nppesnteam/371-24_EKB_academ_PTVM30_-8/DeskRender.jpg

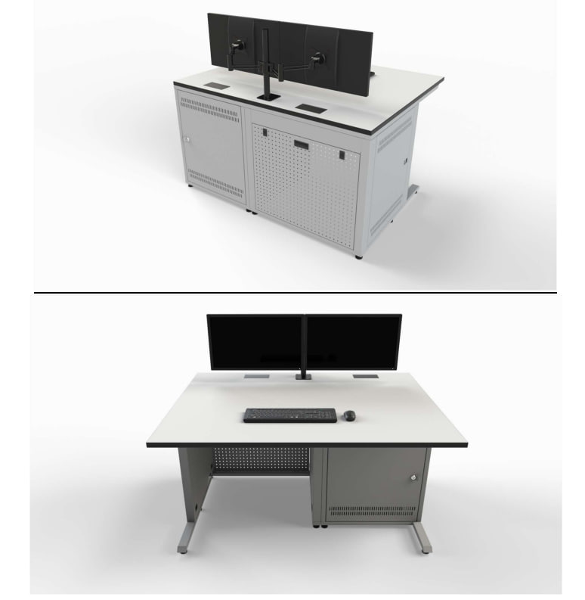
DeskRender.jpg
