nppesnteam/371-24_EKB_academ_PTVM30_-8/DeskSize.jpg

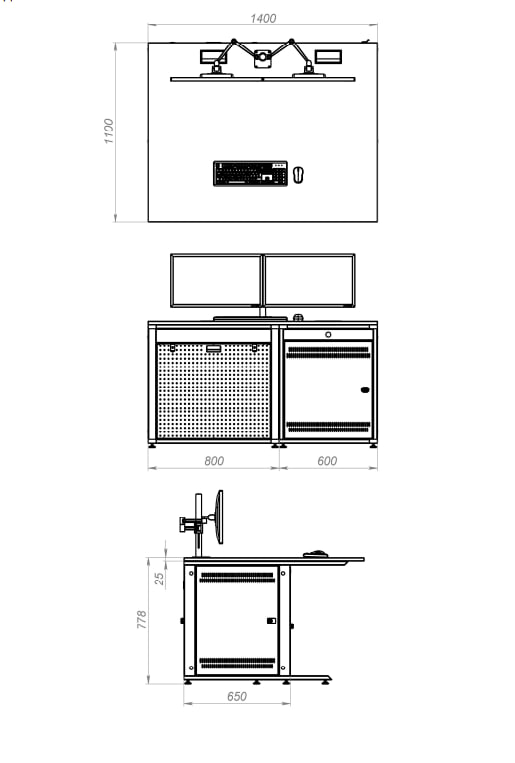
DeskSize.jpg
