nppesnteam/371-24_EKB_academ_PTVM30_-8/Счет №3499 от 23.05.24-1.JPG

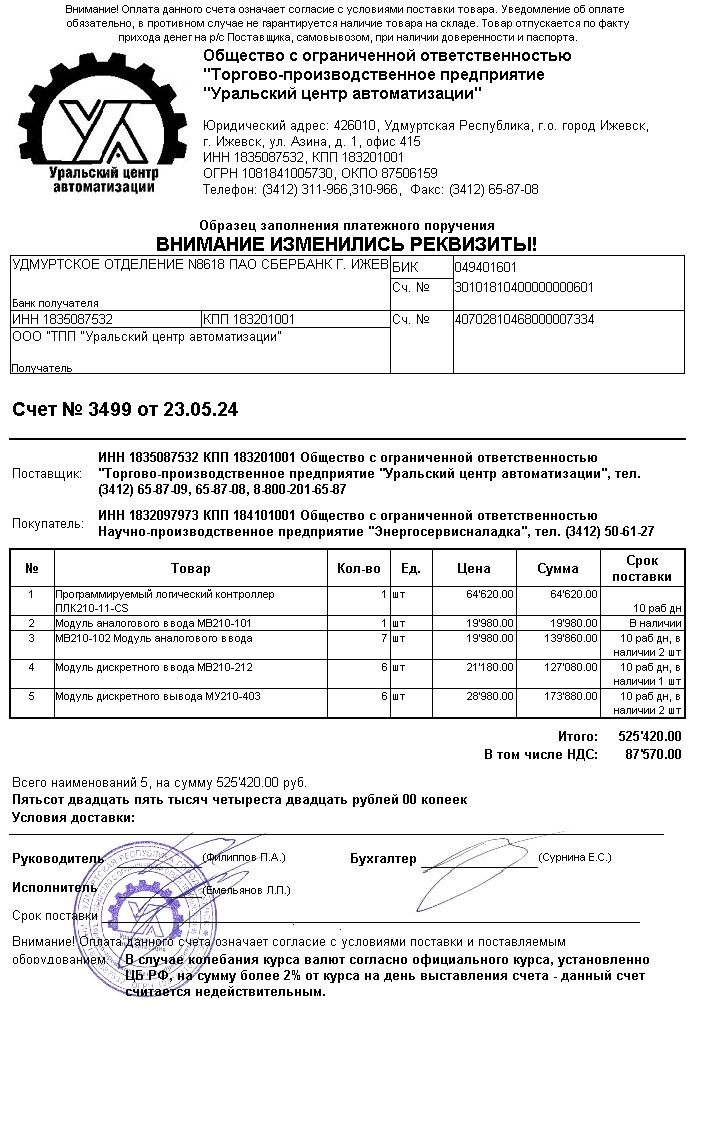
Счет №3499 от 23.05.24-1.JPG
