nppesnteam/371-24_EKB_academ_PTVM30_-8/model371.xlsx

Sheet: 240521кор
№ п/п | шифр | назначение | наименование | производитель | предел от | предел до | ед.изм | Ду | эн.потр | масса | цена без НДС | дата цены | схема эл. | схема монт. | параметры схем
115 | х8СН001 | Датчик контроля загазованности по метану | ДАК-СН4-027 | Аналитприбор, Смоленск
116 | х8СН002 | Датчик контроля загазованности по метану | ДАК-СН4-027 | Аналитприбор, Смоленск
117 | х8СН003 | Датчик контроля загазованности по метану | ДАК-СН4-027 | Аналитприбор, Смоленск
118 | х8СО001 | Датчик контроля загазованности по угарному газу | ДАХ-М-05-СО-200 | Аналитприбор, Смоленск
119 | х8СО002 | Датчик контроля загазованности по угарному газу | ДАХ-М-05-СО-200 | Аналитприбор, Смоленск
31 | g8Ps005 | Давление газа после заслонки котла (Рмин) | Датчик-реле DG30В-3 0,25…3 кПа G.Kromschroeder. | Волгатерм, Нижний Новгород | 0.25 | 3 | кПа
32 | g8Ps006 | Давление газа после заслонки котла (Рмакс) | Датчик-реле DG500В-3 10…50 кПа G.Kromschroeder. | Волгатерм, Нижний Новгород | 10 | 50 | кПа
48 | f8Ps001 | Разрежение в топке котла (мин разреж) | Датчик-реле DL1,5A-3Z -50…150 Па G.Kromschroeder. | Волгатерм, Нижний Новгород | -50 | 150 | Па
71 | a8Ps111 | Давление воздуха перед горелкой 1 (Рмин) | Датчик-реле DG10А-31 0,1…1 кПа G.Kromschroeder. | Волгатерм, Нижний Новгород | 0.1 | 1 | кПа
72 | a8Ps121 | Давление воздуха перед горелкой 2 (Рмин) | Датчик-реле DG10А-31 0,1…1 кПа G.Kromschroeder. | Волгатерм, Нижний Новгород | 0.1 | 1 | кПа
73 | a8Ps131 | Давление воздуха перед горелкой 3 (Рмин) | Датчик-реле DG10А-31 0,1…1 кПа G.Kromschroeder. | Волгатерм, Нижний Новгород | 0.1 | 1 | кПа
74 | a8Ps241 | Давление воздуха перед горелкой 4 (Рмин) | Датчик-реле DG10А-31 0,1…1 кПа G.Kromschroeder. | Волгатерм, Нижний Новгород | 0.1 | 1 | кПа
75 | a8Ps251 | Давление воздуха перед горелкой 5 (Рмин) | Датчик-реле DG10А-31 0,1…1 кПа G.Kromschroeder. | Волгатерм, Нижний Новгород | 0.1 | 1 | кПа
76 | a8Ps261 | Давление воздуха перед горелкой 6 (Рмин) | Датчик-реле DG10А-31 0,1…1 кПа G.Kromschroeder. | Волгатерм, Нижний Новгород | 0.1 | 1 | кПа
27 | g8Pg002 | Давление газа до общей заслонки газа | Манометр показывающий МП4-У У2; 0-60 кПа кл.1,0 160мм | Манотомь, Томск | 0 | 60 | кПа
30 | g8Pg004 | Давление газа после общей заслонки | Манометр показывающий МП4-У У2; 0-60 кПа кл.1,0 160мм | Манотомь, Томск | 0 | 60 | кПа
33 | g8Pg007 | Давление газа между задвижками | Манометр показывающий МП4-У У2; 0-60 кПа кл.1,0 160мм | Манотомь, Томск | 0 | 60 | кПа
34 | g8Pg008 | Давление газа перед главным отсекающим клапаном | Манометр показывающий МП4-У У2; 0-60 кПа кл.1,0 160мм | Манотомь, Томск | 0 | 60 | кПа
112 | w8Pg021 | Давление теплоносителя до котла | Манометр показывающий МП4-У У2; 0-1,6 МПа кл.1,0 160мм | Манотомь, Томск | 0 | 1.6 | МПа
83 | b8X101 | Датчик пламени растопочной горелки 1 группы горелок 1 | ФДСА-03М-01, узел монтажный и фланец к нему | НПП ПромАВ, Казань
84 | b8X111 | Защитно-сигнализирующее утройство горелки 1 | ЗСУ-ПИ-60-700-01 | НПП ПромАВ, Казань
85 | b8X112 | Датчик пламени ЗСУ горелки 1 | ЛУЧ-КЭ-Щв комплекте ЗСУ | НПП ПромАВ, Казань
86 | b8X113 | Источник высокого напряжения ЗСУ горелки 1 | ИВН-ТРМв комплекте ЗСУ | НПП ПромАВ, Казань
87 | b8X121 | Защитно-сигнализирующее утройство горелки 2 | ЗСУ-ПИ-60-700-01 | НПП ПромАВ, Казань
88 | b8X122 | Датчик пламени ЗСУ горелки 2 | ЛУЧ-КЭ-Щ в комплекте ЗСУ | НПП ПромАВ, Казань
89 | b8X123 | Источник высокого напряжения ЗСУ горелки 2 | ИВН-ТРМ в комплекте ЗСУ | НПП ПромАВ, Казань
90 | b8X131 | Защитно-сигнализирующее утройство горелки 3 | ЗСУ-ПИ-60-700-01 | НПП ПромАВ, Казань
91 | b8X132 | Датчик пламени ЗСУ горелки 3 | ЛУЧ-КЭ-Щ в комплекте ЗСУ | НПП ПромАВ, Казань
92 | b8X133 | Источник высокого напряжения ЗСУ горелки 3 | ИВН-ТРМ в комплекте ЗСУ | НПП ПромАВ, Казань
93 | b8X201 | Датчик пламени растопочной горелки 6 группы горелок 2 | ФДСА-03М-01, узел монтажный и фланец к нему | НПП ПромАВ, Казань
94 | b8X241 | Защитно-сигнализирующее утройство горелки 4 | ЗСУ-ПИ-60-700-01 | НПП ПромАВ, Казань
95 | b8X242 | Датчик пламени ЗСУ горелки 4 | ЛУЧ-КЭ-Щ в комплекте ЗСУ | НПП ПромАВ, Казань
96 | b8X243 | Источник высокого напряжения ЗСУ горелки 4 | ИВН-ТРМ в комплекте ЗСУ | НПП ПромАВ, Казань
97 | b8X251 | Защитно-сигнализирующее утройство горелки 5 | ЗСУ-ПИ-60-700-01 | НПП ПромАВ, Казань
98 | b8X252 | Датчик пламени ЗСУ горелки 5 | ЛУЧ-КЭ-Щ в комплекте ЗСУ | НПП ПромАВ, Казань
99 | b8X253 | Источник высокого напряжения ЗСУ горелки 5 | ИВН-ТРМ в комплекте ЗСУ | НПП ПромАВ, Казань
100 | b8X261 | Защитно-сигнализирующее утройство горелки 6 | ЗСУ-ПИ-60-700-01 | НПП ПромАВ, Казань
101 | b8X262 | Датчик пламени ЗСУ горелки 6 | ЛУЧ-КЭ-Щ в комплекте ЗСУ | НПП ПромАВ, Казань
102 | b8X263 | Источник высокого напряжения ЗСУ горелки 6 | ИВН-ТРМ в комплекте ЗСУ | НПП ПромАВ, Казань
37 | g8Pg102 | Давление газа перед группой горелок 1 | Напоромер мембранный НМП-100- М1Р-40кПа. ТУ-25-7305.016-90 | Саранский приборострительный завод | 0 | 40 | кПа
38 | g8Pg202 | Давление газа перед группой горелок 2 | Напоромер мембранный НМП-100- М1Р-40кПа. ТУ-25-7305.016-90 | Саранский приборострительный завод | 0 | 40 | кПа
39 | g8Pt111 | Давление газа перед горелкой 1 | Напоромер мембранный НМП-52-М2- 40кПа-1,5- У3 | Саранский приборострительный завод | 0 | 40 | кПа
40 | g8Pt121 | Давление газа перед горелкой 2 | Напоромер мембранный НМП-52-М2- 40кПа-1,5- У3 | Саранский приборострительный завод | 0 | 40 | кПа
41 | g8Pt131 | Давление газа перед горелкой 3 | Напоромер мембранный НМП-52-М2- 40кПа-1,5- У3 | Саранский приборострительный завод | 0 | 40 | кПа
42 | g8Pt241 | Давление газа перед горелкой 4 | Напоромер мембранный НМП-52-М2- 40кПа-1,5- У3 | Саранский приборострительный завод | 0 | 40 | кПа
43 | g8Pt251 | Давление газа перед горелкой 5 | Напоромер мембранный НМП-52-М2- 40кПа-1,5- У3 | Саранский приборострительный завод | 0 | 40 | кПа
44 | g8Pt261 | Давление газа перед горелкой 6 | Напоромер мембранный НМП-52-М2- 40кПа-1,5- У3 | Саранский приборострительный завод | 0 | 40 | кПа
47 | f8Pg001 | Разрежение в топке котла | Тягонапоромер мембранный ТНМП-100-М1- ±0,125кПа-1,5- У3 | Саранский приборострительный завод | -0.125 | 0.125 | кПа
50 | f8Pg002 | Разрежение перед дымососом | Тягонапоромер мембранный ТмМП-52-М2- 0,6кПа..0-1,5- У3 | Саранский приборострительный завод | -0.6 | 0 | кПа
56 | a8Pg101 | Давления воздуха после вентилятора группы горелок 1 | Напоромер мембранный НМП-52-М2- 2,5кПа-1,5- У3 | Саранский приборострительный завод | 0 | 2.5 | кПа
60 | a8Pg201 | Давления воздуха после вентилятора группы горелок 2 | Напоромер мембранный НМП-52-М2- 2,5кПа-1,5- У3 | Саранский приборострительный завод | 0 | 2.5 | кПа
63 | a8Pg002 | Давления воздуха в общем коллекторе | Напоромер мембранный НМП-52-М2- 2,5кПа-1,5- У3 | Саранский приборострительный завод | 0 | 2.5 | кПа
65 | a8Pg111 | Давление воздуха перед горелкой 1 | Напоромер мембранный НМП-52-М2- 2,5кПа-1,5- У3 | Саранский приборострительный завод | 0 | 2.5 | кПа
66 | a8Pg121 | Давление воздуха перед горелкой 2 | Напоромер мембранный НМП-52-М2- 2,5кПа-1,5- У3 | Саранский приборострительный завод | 0 | 2.5 | кПа
67 | a8Pg131 | Давление воздуха перед горелкой 3 | Напоромер мембранный НМП-52-М2- 2,5кПа-1,5- У3 | Саранский приборострительный завод | 0 | 2.5 | кПа
68 | a8Pg241 | Давление воздуха перед горелкой 4 | Напоромер мембранный НМП-52-М2- 2,5кПа-1,5- У3 | Саранский приборострительный завод | 0 | 2.5 | кПа
69 | a8Pg251 | Давление воздуха перед горелкой 5 | Напоромер мембранный НМП-52-М2- 2,5кПа-1,5- У3 | Саранский приборострительный завод | 0 | 2.5 | кПа
70 | a8Pg261 | Давление воздуха перед горелкой 6 | Напоромер мембранный НМП-52-М2- 2,5кПа-1,5- У3 | Саранский приборострительный завод | 0 | 2.5 | кПа
46 | f8sM002 | Шибер дымососа | МЭО-630/63-0,25У-08К | СКБ СПА, Чебоксары
55 | a8sM101 | Шибер воздуха вентилятора группы горелок 1 | МЭО-250/63-0,25У-08К | СКБ СПА, Чебоксары
59 | a8sM201 | Шибер воздуха вентилятора группы горелок 2 | МЭО-250/63-0,25У-08К | СКБ СПА, Чебоксары
77 | a8sM111 | Шибер воздуха горелки 1 | МЭО-100/25-0,25У-08 | СКБ СПА, Чебоксары
78 | a8sM121 | Шибер воздуха горелки 2 | МЭО-100/25-0,25У-08 | СКБ СПА, Чебоксары
79 | a8sM131 | Шибер воздуха горелки 3 | МЭО-100/25-0,25У-08 | СКБ СПА, Чебоксары
80 | a8sM241 | Шибер воздуха горелки 4 | МЭО-100/25-0,25У-08 | СКБ СПА, Чебоксары
81 | a8sM251 | Шибер воздуха горелки 5 | МЭО-100/25-0,25У-08 | СКБ СПА, Чебоксары
82 | a8sM261 | Шибер воздуха горелки 6 | МЭО-100/25-0,25У-08 | СКБ СПА, Чебоксары
106 | w8Tg012 | Температура теплоносителя после котла | Термометр биметаллический ТБ-2Р(0…200)-1,5-250-10-М20 ТУ 311-00225621.160-96 | Теплоконтроль, Казань | 0 | 200 | град.С
114 | w8Tg022 | Температура теплоносителя до котла | Термометр биметаллический ТБ-2Р(0…200)-1,5-250-10-М20 ТУ 311-00225621.160-96 | Теплоконтроль, Казань | 0 | 200 | град.С
2 | g8V002 | Главный ПЗК НЗ котла | ВН8Н-6Пст | Термобрест |  | 600 | кПа | 200
3 | g8sM003 | Заслонка общекотловая | ЗР6-6ВПРст | Термобрест |  | 600 | кПа | 150
4 | g8V004 | Клапан НЗ продувки между задвижками | ВН2Н-6Пст.фл | Термобрест |  | 600 | кПа | 50
5 | g8V005 | Клапан НЗ продувки газопровода перед ГОК | ВН2Н-6Пст.фл | Термобрест |  | 600 | кПа | 50
6 | g8V006 | Клапан НЗ продувки газопровода из тупика | ВН2Н-6Пст.фл | Термобрест |  | 600 | кПа | 50
7 | g8V101 | ПЗК1 НЗ группы горелок 1 | ВН6Н-6Пст | Термобрест |  | 600 | кПа | 150
8 | g8V201 | ПЗК1 НЗ группы горелок 2 | ВН6Н-6Пст | Термобрест |  | 600 | кПа | 150
9 | g8V102 | Клапан НЗ опрессовки группы горелок 1 | ВН¾Н-6Пст | Термобрест |  | 600 | кПа | 20
10 | g8V202 | Клапан НЗ опрессовки группы горелок 2 | ВН¾Н-6Пст | Термобрест |  | 600 | кПа | 20
11 | g8V103 | Клапан НО безопасности группы горелок 1 | ВФ1Н-6Пст | Термобрест |  | 600 | кПа | 25
12 | g8V203 | Клапан НО безопасности группы горелок 2 | ВФ1Н-6Пст | Термобрест |  | 600 | кПа | 25
13 | g8VsM111 | ПЗК2 НЗ горелки 1 со встроенной заслонкой после него | ВН3М-3КПст(SP0) | Термобрест |  | 300 | кПа | 80
14 | g8VsM121 | ПЗК2 НЗ горелки 2 со встроенной заслонкой после него | ВН3М-3КПст(SP0) | Термобрест |  | 300 | кПа | 80
15 | g8VsM131 | ПЗК2 НЗ горелки 3 со встроенной заслонкой после него | ВН3М-3КПст(SP0) | Термобрест |  | 300 | кПа | 80
16 | g8VsM241 | ПЗК2 НЗ горелки 4 со встроенной заслонкой после него | ВН3М-3КПст(SP0) | Термобрест |  | 300 | кПа | 80
17 | g8VsM251 | ПЗК2 НЗ горелки 5 со встроенной заслонкой после него | ВН3М-3КПст(SP0) | Термобрест |  | 300 | кПа | 80
18 | g8VsM261 | ПЗК2 НЗ горелки 6 со встроенной заслонкой после него | ВН3М-3КПст(SP0) | Термобрест |  | 300 | кПа | 80
19 | g8V112 | Клапан НЗ запальника горелки 1 | ВН¾Н-6Пст | Термобрест |  | 600 | кПа | 20
20 | g8V122 | Клапан НЗ запальника горелки 2 | ВН¾Н-6Пст | Термобрест |  | 600 | кПа | 20
21 | g8V132 | Клапан НЗ запальника горелки 3 | ВН¾Н-6Пст | Термобрест |  | 600 | кПа | 20
22 | g8V242 | Клапан НЗ запальника горелки 4 | ВН¾Н-6Пст | Термобрест |  | 600 | кПа | 20
23 | g8V252 | Клапан НЗ запальника горелки 5 | ВН¾Н-6Пст | Термобрест |  | 600 | кПа | 20
24 | g8V262 | Клапан НЗ запальника горелки 6 | ВН¾Н-6Пст | Термобрест |  | 600 | кПа | 20
25 | g8dPt001 | Перепад давление газа на диафрагме (расход) | Преобразователь давления измерительный АИР-20/М2/-/Н//ДД/410/-/-/11V/А3И1/t4070/A01/0...6,3кПа/10МПа/42/ШР-14/К1+/IP65/КР3/-/Y(С30)/KKS/ГП/ТУ, Блок клапанный ЭЛЕМЕР-БК/С/3/0/-/02/03/Р5/t4070 У3/ДР/М20УМ/- в комплекте с диафрагмой ДКС и устройством подготовки потока УПП | Элемер, Зеленоград МО | 0 | 6.3 | кПа
26 | g8Pt002 | Давление газа перед общекотловой заслонкой | Преобразователь давления измерительный АИР-20/М2/-/Н//ДИ/130/-/М20/11N/А3И1/t4070/А00/0...60кПа/42/ШР-14/К1+/IP65/КР2/Т7ФУ/-/KKS/ГП/ТУ | Элемер, Зеленоград МО | 0 | 60 | кПа
28 | g8Te003 | Температура газа перед котлом | Термопреобразователь сопротивления ТС-1088/-/1/-/50М/-50…+200°С/160/10/В/АГ-10/С/Сх.№2/ГП/ЭП | Элемер, Зеленоград МО | -50 | 200 | град.С
29 | g8Pt004 | Давление газа после общекотловой заслонкой | Преобразователь давления измерительный АИР-20/М2/-/Н//ДИ/120/-/М20/11N/А3И1/t4070/A01/0...40кПа/42/ШР-14/К1+/IP65/КР2/Т7ФУ/-/KKS/ГП/ТУ | Элемер, Зеленоград МО | 0 | 40 | кПа
35 | g8Pt101 | Давление между клапанов группы горелок 1 | Преобразователь давления измерительный АИР-10/-/SH/ДИ/1130/-/-/0...60кПа/C05/АГ-15И/М20/11N/t4070/42/IP65/PGM/-/-/-/-/-/-/KKS/-/-/-/ГП/ТУ | Элемер, Зеленоград МО | 0 | 60 | кПа
36 | g8Pt201 | Давление между клапанов группы горелок 2 | Преобразователь давления измерительный АИР-10/-/SH/ДИ/1130/-/-/0...60кПа/C05/АГ-15И/М20/11N/t4070/42/IP65/PGM/-/-/-/-/-/-/KKS/-/-/-/ГП/ТУ | Элемер, Зеленоград МО | 0 | 60 | кПа
49 | f8Pt001 | Разрежение в топке котла | Преобразователь давления измерительный АИР-20/М2/-/Н//ДИВ/304/-/-/11V/А3И1/t4070/B02/-0,2...2,0кПа/42/ШР-14/К1+/IP65/КР3/С5ФФ/-/KKS/ГП/ТУ | Элемер, Зеленоград МО | -0.2 | 0.2 | кПа
51 | f8Te003 | Температура дымовых газов за котлом | Термопреобразователь сопротивления ТС-1088/-/1/-/100П/–100…+450С/500/10/А/АГ-10/С/Сх.№2/ГП/ЭП | Элемер, Зеленоград МО | -100 | 450 | град.С
62 | a8Te001 | Температура воздуха в общем коллекторе | Термопреобразователь сопротивления ТС-1088/-/1/-/50М/-50…+200°С/400/10/В/АГ-10/С/Сх.№2/ГП/ЭП | Элемер, Зеленоград МО | -50 | 200 | град.С
64 | a8Pt002 | Давление воздуха в общем коробе | Преобразователь давления измерительный АИР-20/М2/-/Н//ДИ/114/-/-/11V/А3И1/t4070/A01/0...2,5кПа/42/ШР-14/К1+/IP65/КР3/С5ФФ/-/KKS/ГП/ТУ | Элемер, Зеленоград МО | 0 | 2.5 | кПа
104 | w8dPt011 | Перепад давления теплоносителя на диафрагме после котла | Преобразователь давления измерительный АИР-20/М2/-/Н//ДД/440/-/-/11V/А3И1/t4070/А00/0...63кПа/10МПа/42/ШР-14/К1+/IP65/КР3/-/Y(С30)/KKS/ГП/ТУ; Блок клапанный ЭЛЕМЕР-БК/С/3/0/-/02/03/Р5/t4070 У3/ДР/М20УМ/-; с заменой существующей камерной диафрагмы на диафрагмы ДКС | Элемер, Зеленоград МО | 0 | 63 | кПа
105 | w8Te012 | Температура теплоносителя после котла | Термопреобразователь сопротивления ТС-1088/-/1/-/50М/-50…+200°С/250/10/С/АГ-10/С/Сх.№2/ГП/ЭП | Элемер, Зеленоград МО | -50 | 200 | град.С
107 | w8Te013 | Температура теплоносителя после котла (дубль) | Термопреобразователь сопротивления ТС-1088/-/1/-/50М/-50…+200°С/250/10/С/АГ-10/С/Сх.№2/ГП/ЭП | Элемер, Зеленоград МО | -50 | 200 | град.С
108 | w8Pt014 | Давление теплоносителя после котла | Преобразователь давления измерительный АИР-20/М2/-/Н//ДИ/160/-/М20/11N/А3И1/t4070/А00/0...1,6МПа/42/ШР-14/К1+/IP65/КР2/Т7ФУ/-/KKS/ГП/ТУ | Элемер, Зеленоград МО | 0 | 1.6 | Мпа
109 | w8Psg014 | ЭКМ на трубопроводе воды после котла | Электроконтактный манометр ЭКМ 2005/-/ДИ/ИМ1,6М/1,6/МПа/D/V/А16И1/t0550/24/-/GSP/М20/11N/-/ГП/ЭП | Элемер, Зеленоград МО | 0 | 1.6 | МПа
111 | w8Pt021 | Давление теплоносителя до котла | Преобразователь давления измерительный АИР-20/М2/-/Н//ДИ/160/-/М20/11N/А3И1/t4070/А00/0...1,6МПа/42/ШР-14/К1+/IP65/КР2/Т7ФУ/-/KKS/ГП/ТУ | Элемер, Зеленоград МО | 0 | 1.6 | Мпа
113 | w8Te022 | Температура теплоносителя до котла | Термопреобразователь сопротивления ТС-1088/-/1/-/50М/-50…+200°С/250/10/С/АГ-10/С/Сх.№2/ГП/ЭП | Элемер, Зеленоград МО | -50 | 200 | град.С
1 | g8M001 | Задвижка общекотловая | 30с 941нж с электроприводом ГЗ-Б.300/24, 380В | Южноураларматура, Миасс |  | 1600 | кПа | 200
103 | w8M011 | Задвижка общекотловая | 30с 964нж с электроприводом ГЗ-Б.300/24, 380В | Южноураларматура, Миасс |  | 2500 | кПа | 250
110 | w8M021 | Задвижка общекотловая | 30с 964нж с электроприводом ГЗ-Б.300/24, 380В | Южноураларматура, Миасс |  | 2500 | кПа | 250
45 | f8M001 | Дымосос сущ
52 | f8X004 | Датчик вибраций электродвигателя дымососа | Будет предложено Заказчиком, выход 4..20 |  |  |  | мм/с
53 | f8X005 | Газоанализатор O2+CO | МАК-2000, выход 4..20 | Энергопромкомплект, Москва |  |  | мм/с
54 | a8M101 | Вентилятор 1 сущ
57 | a8X102 | Датчик вибраций электродвигателя вентилятора 1 | Будет предложено Заказчиком, выход 4..20 |  |  |  | мм/с
58 | a8M201 | Вентилятор 2 сущ
61 | a8X202 | Датчик вибраций электродвигателя вентилятора 2 | Будет предложено Заказчиком, выход 4..20 |  |  |  | мм/с

Sheet: 240501кор
шифр | назначение | наименование | производитель | предел от | предел до | ед.изм | Ду | эн.потр | масса | цена без НДС | дата цены | схема эл. | схема монт. | параметры схем
g8M001 | Задвижка общекотловая | 30с 941нж с электроприводом ГЗ-Б.300/24, 380В | Южноураларматура, Миасс |  | 1600 |  | 200 |  | 127 | 234720 | 2024-04-22
g8V002 | Главный ПЗК НЗ котла | КМГ-200Ф-100 | Теплотехника, Переяславль-Залесский |  | 100 |  | 200 |  | 79.0 | 191490 | 2024-04-22
g8sM003 | Заслонка общекотловая | ЗГД-150ФМ3-600, привод МЭОФ | Теплотехника, Переяславль-Залесский |  | 600 |  | 150 |  | 15.0 | 30910 | 2024-04-22
g8V004 | Клапан НЗ продувки между задвижками | КМГ-50Ф-100 | Теплотехника, Переяславль-Залесский |  | 100 |  | 50 |  | 5.4 | 20590 | 2024-04-22
g8V005 | Клапан НЗ продувки газопровода перед ГОК | КМГ-50Ф-100 | Теплотехника, Переяславль-Залесский |  | 100 |  | 50 |  | 5.4 | 20590 | 2024-04-22
g8V006 | Клапан НЗ продувки газопровода из тупика | КМГ-50Ф-100 | Теплотехника, Переяславль-Залесский |  | 100 |  | 50 |  | 5.4 | 20590 | 2024-04-22
g8V101 | ПЗК1 НЗ группы горелок 1 | КМГ-150Ф-100 | Теплотехника, Переяславль-Залесский |  | 100 |  | 150 |  | 64.0 | 120720 | 2024-04-22
g8V201 | ПЗК1 НЗ группы горелок 2 | КМГ-150Ф-100 | Теплотехника, Переяславль-Залесский |  | 100 |  | 150 |  | 64.0 | 120720 | 2024-04-22
g8V102 | Клапан НЗ опрессовки группы горелок 1 | КМГ-20-100 | Теплотехника, Переяславль-Залесский |  | 100 |  | 20 |  | 2.8 | 11540 | 2024-04-22
g8V202 | Клапан НЗ опрессовки группы горелок 2 | КМГ-20-100 | Теплотехника, Переяславль-Залесский |  | 100 |  | 20 |  | 2.8 | 11540 | 2024-04-22
g8V103 | Клапан НО безопасности группы горелок 1 | КМГ-20НО-100 | Теплотехника, Переяславль-Залесский |  | 100 |  | 20 |  | 2.6 | 14210 | 2024-04-22
g8V203 | Клапан НО безопасности группы горелок 2 | КМГ-20НО-100 | Теплотехника, Переяславль-Залесский |  | 100 |  | 20 |  | 2.6 | 14210 | 2024-04-22
g8V111 | ПЗК2 НЗ горелки 1 | КМГ-100ФР-100 | Теплотехника, Переяславль-Залесский |  | 100 |  | 100 |  | 17.6 | 51300 | 2024-04-22
g8V121 | ПЗК2 НЗ горелки 2 | КМГ-100ФР-100 | Теплотехника, Переяславль-Залесский |  | 100 |  | 100 |  | 17.6 | 51300 | 2024-04-22
g8V131 | ПЗК2 НЗ горелки 3 | КМГ-100ФР-100 | Теплотехника, Переяславль-Залесский |  | 100 |  | 100 |  | 17.6 | 51300 | 2024-04-22
g8V241 | ПЗК2 НЗ горелки 4 | КМГ-100ФР-100 | Теплотехника, Переяславль-Залесский |  | 100 |  | 100 |  | 17.6 | 51300 | 2024-04-22
g8V251 | ПЗК2 НЗ горелки 5 | КМГ-100ФР-100 | Теплотехника, Переяславль-Залесский |  | 100 |  | 100 |  | 17.6 | 51300 | 2024-04-22
g8V261 | ПЗК2 НЗ горелки 6 | КМГ-100ФР-100 | Теплотехника, Переяславль-Залесский |  | 100 |  | 100 |  | 17.6 | 51300 | 2024-04-22
g8sM112 | Заслонка горелки 1 | ЗГД-100ФМ3-600, привод МЭОФ | Теплотехника, Переяславль-Залесский |  | 600 |  | 100 |  | 6.7 | 25200 | 2024-04-22
g8sM122 | Заслонка горелки 2 | ЗГД-100ФМ3-600, привод МЭОФ | Теплотехника, Переяславль-Залесский |  | 600 |  | 100 |  | 6.7 | 25200 | 2024-04-22
g8sM132 | Заслонка горелки 3 | ЗГД-100ФМ3-600, привод МЭОФ | Теплотехника, Переяславль-Залесский |  | 600 |  | 100 |  | 6.7 | 25200 | 2024-04-22
g8sM242 | Заслонка горелки 4 | ЗГД-100ФМ3-600, привод МЭОФ | Теплотехника, Переяславль-Залесский |  | 600 |  | 100 |  | 6.7 | 25200 | 2024-04-22
g8sM252 | Заслонка горелки 5 | ЗГД-100ФМ3-600, привод МЭОФ | Теплотехника, Переяславль-Залесский |  | 600 |  | 100 |  | 6.7 | 25200 | 2024-04-22
g8sM262 | Заслонка горелки 6 | ЗГД-100ФМ3-600, привод МЭОФ | Теплотехника, Переяславль-Залесский |  | 600 |  | 100 |  | 6.7 | 25200 | 2024-04-22
g8V113 | Клапан НЗ запальника горелки 1 | КМГ-20-100 | Теплотехника, Переяславль-Залесский |  | 100 |  | 20 |  | 2.8 | 11540 | 2024-04-22
g8V123 | Клапан НЗ запальника горелки 2 | КМГ-20-100 | Теплотехника, Переяславль-Залесский |  | 100 |  | 20 |  | 2.8 | 11540 | 2024-04-22
g8V133 | Клапан НЗ запальника горелки 3 | КМГ-20-100 | Теплотехника, Переяславль-Залесский |  | 100 |  | 20 |  | 2.8 | 11540 | 2024-04-22
g8V243 | Клапан НЗ запальника горелки 4 | КМГ-20-100 | Теплотехника, Переяславль-Залесский |  | 100 |  | 20 |  | 2.8 | 11540 | 2024-04-22
g8V253 | Клапан НЗ запальника горелки 5 | КМГ-20-100 | Теплотехника, Переяславль-Залесский |  | 100 |  | 20 |  | 2.8 | 11540 | 2024-04-22
g8V263 | Клапан НЗ запальника горелки 6 | КМГ-20-100 | Теплотехника, Переяславль-Залесский |  | 100 |  | 20 |  | 2.8 | 11540 | 2024-04-22
g8dPt001 | Перепад давление газа на диафрагме (расход) | Преобразователь давления измерительный АИР-20/М2/-/Н//ДД/410/-/-/11V/А3И1/t4070/A01/0...6,3кПа/10МПа/42/ШР-14/К1+/IP65/КР3/-/Y(С30)/KKS/ГП/ТУ, Блок клапанный ЭЛЕМЕР-БК/С/3/0/-/02/03/Р5/t4070 У3/ДР/М20УМ/- | Элемер, Зеленоград МО | 0 | 6.3 | кПа |  |  | 6 | 132470 | 2024-04-22
g8Pt002 | Давление газа перед общекотловой заслонкой | Преобразователь давления измерительный АИР-20/М2/-/Н//ДИ/130/-/М20/11N/А3И1/t4070/А00/0...60кПа/42/ШР-14/К1+/IP65/КР2/Т7ФУ/-/KKS/ГП/ТУ | Элемер, Зеленоград МО | 0 | 60 | кПа |  |  | 2 | 76895 | 2024-04-22
g8Pg002 | Давление газа до общей заслонки газа | Манометр показывающий МП4-У У2; 0-60 кПа кл.1,0 160мм | Манотомь, Томск | 0 | 60 | кПа
g8Te003 | Температура газа перед котлом | Термопреобразователь сопротивления ТС-1088/-/1/-/50М/-50…+200°С/160/10/В/АГ-10/С/Сх.№2/ГП/ЭП | Элемер, Зеленоград МО | -50 | 200 | град.С |  |  | 0.8 | 4705 | 2024-04-22
g8Pt004 | Давление газа после общекотловой заслонкой | Преобразователь давления измерительный АИР-20/М2/-/Н//ДИ/120/-/М20/11N/А3И1/t4070/A01/0...40кПа/42/ШР-14/К1+/IP65/КР2/Т7ФУ/-/KKS/ГП/ТУ | Элемер, Зеленоград МО | 0 | 40 | кПа |  |  | 2 | 76245 | 2024-04-22
g8Pg004 | Давление газа после общей заслонки | Манометр показывающий МП4-У У2; 0-60 кПа кл.1,0 160мм | Манотомь, Томск | 0 | 60 | кПа
g8Ps005 | Давление газа после заслонки котла (Рмин) | Датчик-реле DG30В-3 0,25…3 кПа G.Kromschroeder. | Волгатерм, Нижний Новгород | 0.25 | 3 | кПа |  |  | 0.3 | 25961 | сайт
g8Ps006 | Давление газа после заслонки котла (Рмакс) | Датчик-реле DG500В-3 10…50 кПа G.Kromschroeder. | Волгатерм, Нижний Новгород | 10 | 50 | кПа |  |  | 0.3 | 27938 | сайт
g8Pg007 | Давление газа между задвижками | Манометр показывающий МП4-У У2; 0-60 кПа кл.1,0 160мм | Манотомь, Томск | 0 | 60 | кПа
g8Pg008 | Давление газа перед главным отсекающим клапаном | Манометр показывающий МП4-У У2; 0-60 кПа кл.1,0 160мм | Манотомь, Томск | 0 | 60 | кПа
g8Pt101 | Давление между клапанов группы горелок 1 | Преобразователь давления измерительный АИР-10/-/SH/ДИ/1130/-/-/0...60кПа/C05/АГ-15И/М20/11N/t4070/42/IP65/PGM/-/-/-/-/-/-/KKS/-/-/-/ГП/ТУ | Элемер, Зеленоград МО | 0 | 60 | кПа |  |  | 2 | 43680 | 2024-04-22
g8Pt201 | Давление между клапанов группы горелок 2 | Преобразователь давления измерительный АИР-10/-/SH/ДИ/1130/-/-/0...60кПа/C05/АГ-15И/М20/11N/t4070/42/IP65/PGM/-/-/-/-/-/-/KKS/-/-/-/ГП/ТУ | Элемер, Зеленоград МО | 0 | 60 | кПа |  |  | 2 | 43680 | 2024-04-22
g8Pg102 | Давление газа перед группой горелок 1 | Напоромер мембранный НМП-100- М1Р-40кПа. ТУ-25-7305.016-90 | Саранский приборострительный завод | 0 | 40 | кПа
g8Pg202 | Давление газа перед группой горелок 2 | Напоромер мембранный НМП-100- М1Р-40кПа. ТУ-25-7305.016-90 | Саранский приборострительный завод | 0 | 40 | кПа
g8Pt111 | Давление газа перед горелкой 1 | Напоромер мембранный НМП-52-М2- 40кПа-1,5- У3 | Саранский приборострительный завод | 0 | 40 | кПа
g8Pt121 | Давление газа перед горелкой 2 | Напоромер мембранный НМП-52-М2- 40кПа-1,5- У3 | Саранский приборострительный завод | 0 | 40 | кПа
g8Pt131 | Давление газа перед горелкой 3 | Напоромер мембранный НМП-52-М2- 40кПа-1,5- У3 | Саранский приборострительный завод | 0 | 40 | кПа
g8Pt241 | Давление газа перед горелкой 4 | Напоромер мембранный НМП-52-М2- 40кПа-1,5- У3 | Саранский приборострительный завод | 0 | 40 | кПа
g8Pt251 | Давление газа перед горелкой 5 | Напоромер мембранный НМП-52-М2- 40кПа-1,5- У3 | Саранский приборострительный завод | 0 | 40 | кПа
g8Pt261 | Давление газа перед горелкой 6 | Напоромер мембранный НМП-52-М2- 40кПа-1,5- У3 | Саранский приборострительный завод | 0 | 40 | кПа
f8M001 | Дымосос сущ
f8sM002 | Шибер дымососа | МЭО-630/63-0,25У-08К | СКБ СПА, Чебоксары
f8Pg001 | Разрежение в топке котла | Тягонапоромер мембранный ТНМП-100-М1- ±0,125кПа-1,5- У3 | Саранский приборострительный завод | -0.125 | 0.125 | кПа
f8Ps001 | Разрежение в топке котла (мин разреж) | Датчик-реле DL1,5A-3Z -50…150 Па G.Kromschroeder. | Волгатерм, Нижний Новгород | -50 | 150 | Па |  |  | 0.3 | 27400 | сайт
f8Pt001 | Разрежение в топке котла | Преобразователь давления измерительный АИР-20/М2/-/Н//ДИВ/304/-/-/11V/А3И1/t4070/B02/-0,2...2,0кПа/42/ШР-14/К1+/IP65/КР3/С5ФФ/-/KKS/ГП/ТУ | Элемер, Зеленоград МО | -0.2 | 0.2 | кПа |  |  | 5 | 118885 | 2024-04-22
f8Pg002 | Разрежение перед дымососом | Тягонапоромер мембранный ТмМП-52-М2- 0,6кПа..0-1,5- У3 | Саранский приборострительный завод | -0.6 | 0 | кПа
f8Te003 | Температура дымовых газов за котлом | Термопреобразователь сопротивления ТС-1088/-/1/-/100П/–100…+450С/500/10/А/АГ-10/С/Сх.№2/ГП/ЭП | Элемер, Зеленоград МО | -100 | 450 | град.С |  |  | 0.8 | 5905 | 2024-04-22
a8M101 | Вентилятор 1 сущ
a8sM101 | Шибер воздуха вентилятора группы горелок 1 | МЭО-250/63-0,25У-08К | СКБ СПА, Чебоксары
a8Pg101 | Давления воздуха после вентилятора группы горелок 1 | Напоромер мембранный НМП-52-М2- 2,5кПа-1,5- У3 | Саранский приборострительный завод | 0 | 2.5 | кПа
a8M201 | Вентилятор 2 сущ
a8sM201 | Шибер воздуха вентилятора группы горелок 2 | МЭО-250/63-0,25У-08К | СКБ СПА, Чебоксары
a8Pg201 | Давления воздуха после вентилятора группы горелок 2 | Напоромер мембранный НМП-52-М2- 2,5кПа-1,5- У3 | Саранский приборострительный завод | 0 | 2.5 | кПа
a8Te001 | Температура воздуха в общем коробе | Термопреобразователь сопротивления ТС-1088/-/1/-/50М/-50…+200°С/400/10/В/АГ-10/С/Сх.№2/ГП/ЭП | Элемер, Зеленоград МО | -50 | 200 | град.С |  |  |  | 5060 | 2024-04-22
a8Pg002 | Давления воздуха в общем коллекторе | Напоромер мембранный НМП-52-М2- 2,5кПа-1,5- У3 | Саранский приборострительный завод | 0 | 2.5 | кПа
a8Pt002 | Давление воздуха в общем коробе | Преобразователь давления измерительный АИР-20/М2/-/Н//ДИ/114/-/-/11V/А3И1/t4070/A01/0...2,5кПа/42/ШР-14/К1+/IP65/КР3/С5ФФ/-/KKS/ГП/ТУ | Элемер, Зеленоград МО | 0 | 2.5 | кПа |  |  | 2 | 115505 | 2024-04-22
a8Pg111 | Давление воздуха перед горелкой 1 | Напоромер мембранный НМП-52-М2- 2,5кПа-1,5- У3 | Саранский приборострительный завод | 0 | 2.5 | кПа
a8Pg121 | Давление воздуха перед горелкой 2 | Напоромер мембранный НМП-52-М2- 2,5кПа-1,5- У3 | Саранский приборострительный завод | 0 | 2.5 | кПа
a8Pg131 | Давление воздуха перед горелкой 3 | Напоромер мембранный НМП-52-М2- 2,5кПа-1,5- У3 | Саранский приборострительный завод | 0 | 2.5 | кПа
a8Pg241 | Давление воздуха перед горелкой 4 | Напоромер мембранный НМП-52-М2- 2,5кПа-1,5- У3 | Саранский приборострительный завод | 0 | 2.5 | кПа
a8Pg251 | Давление воздуха перед горелкой 5 | Напоромер мембранный НМП-52-М2- 2,5кПа-1,5- У3 | Саранский приборострительный завод | 0 | 2.5 | кПа
a8Pg261 | Давление воздуха перед горелкой 6 | Напоромер мембранный НМП-52-М2- 2,5кПа-1,5- У3 | Саранский приборострительный завод | 0 | 2.5 | кПа
a8Ps111 | Давление воздуха перед горелкой 1 (Рмин) | Датчик-реле DG10А-31 0,1…1 кПа G.Kromschroeder. | Волгатерм, Нижний Новгород | 0.1 | 1 | кПа |  |  | 0.3 | 25059 | сайт
a8Ps121 | Давление воздуха перед горелкой 2 (Рмин) | Датчик-реле DG10А-31 0,1…1 кПа G.Kromschroeder. | Волгатерм, Нижний Новгород | 0.1 | 1 | кПа |  |  | 0.3 | 25059 | сайт
a8Ps131 | Давление воздуха перед горелкой 3 (Рмин) | Датчик-реле DG10А-31 0,1…1 кПа G.Kromschroeder. | Волгатерм, Нижний Новгород | 0.1 | 1 | кПа |  |  | 0.3 | 25059 | сайт
a8Ps241 | Давление воздуха перед горелкой 4 (Рмин) | Датчик-реле DG10А-31 0,1…1 кПа G.Kromschroeder. | Волгатерм, Нижний Новгород | 0.1 | 1 | кПа |  |  | 0.3 | 25059 | сайт
a8Ps251 | Давление воздуха перед горелкой 5 (Рмин) | Датчик-реле DG10А-31 0,1…1 кПа G.Kromschroeder. | Волгатерм, Нижний Новгород | 0.1 | 1 | кПа |  |  | 0.3 | 25059 | сайт
a8Ps261 | Давление воздуха перед горелкой 6 (Рмин) | Датчик-реле DG10А-31 0,1…1 кПа G.Kromschroeder. | Волгатерм, Нижний Новгород | 0.1 | 1 | кПа |  |  | 0.3 | 25059 | сайт
a8sM111 | Шибер воздуха горелки 1 | МЭО-100/25-0,25У-08 | СКБ СПА, Чебоксары
a8sM121 | Шибер воздуха горелки 2 | МЭО-100/25-0,25У-08 | СКБ СПА, Чебоксары
a8sM131 | Шибер воздуха горелки 3 | МЭО-100/25-0,25У-08 | СКБ СПА, Чебоксары
a8sM241 | Шибер воздуха горелки 4 | МЭО-100/25-0,25У-08 | СКБ СПА, Чебоксары
a8sM251 | Шибер воздуха горелки 5 | МЭО-100/25-0,25У-08 | СКБ СПА, Чебоксары
a8sM261 | Шибер воздуха горелки 6 | МЭО-100/25-0,25У-08 | СКБ СПА, Чебоксары
b8X101 | Датчик пламени растопочной горелки 1 группы горелок 1 | ФДСА-03М-01, узел монтажный и фланец к нему | НПП ПромАВ, Казань |  |  |  |  |  |  | 42192 | 2023-10-01
b8X111 | Защитно-сигнализирующее утройство горелки 1 | ЗСУ-ПИ-60-700-01 | НПП ПромАВ, Казань
b8X112 | Датчик пламени ЗСУ горелки 1 | ЛУЧ-КЭ-Щв комплекте ЗСУ | НПП ПромАВ, Казань |  |  |  |  |  |  | 10020 | 2023-10-01
b8X113 | Источник высокого напряжения ЗСУ горелки 1 | ИВН-ТРМв комплекте ЗСУ | НПП ПромАВ, Казань |  |  |  |  |  |  | 4596 | 2023-10-01
b8X121 | Защитно-сигнализирующее утройство горелки 2 | ЗСУ-ПИ-60-700-01 | НПП ПромАВ, Казань
b8X122 | Датчик пламени ЗСУ горелки 2 | ЛУЧ-КЭ-Щ в комплекте ЗСУ | НПП ПромАВ, Казань |  |  |  |  |  |  | 10020 | 2023-10-01
b8X123 | Источник высокого напряжения ЗСУ горелки 2 | ИВН-ТРМ в комплекте ЗСУ | НПП ПромАВ, Казань |  |  |  |  |  |  | 4596 | 2023-10-01
b8X131 | Защитно-сигнализирующее утройство горелки 3 | ЗСУ-ПИ-60-700-01 | НПП ПромАВ, Казань
b8X132 | Датчик пламени ЗСУ горелки 3 | ЛУЧ-КЭ-Щ в комплекте ЗСУ | НПП ПромАВ, Казань |  |  |  |  |  |  | 10020 | 2023-10-01
b8X133 | Источник высокого напряжения ЗСУ горелки 3 | ИВН-ТРМ в комплекте ЗСУ | НПП ПромАВ, Казань |  |  |  |  |  |  | 4596 | 2023-10-01
b8X201 | Датчик пламени растопочной горелки 6 группы горелок 2 | ФДСА-03М-01, узел монтажный и фланец к нему | НПП ПромАВ, Казань |  |  |  |  |  |  | 42192 | 2023-10-01
b8X241 | Защитно-сигнализирующее утройство горелки 4 | ЗСУ-ПИ-60-700-01 | НПП ПромАВ, Казань
b8X242 | Датчик пламени ЗСУ горелки 4 | ЛУЧ-КЭ-Щ в комплекте ЗСУ | НПП ПромАВ, Казань |  |  |  |  |  |  | 10020 | 2023-10-01
b8X243 | Источник высокого напряжения ЗСУ горелки 4 | ИВН-ТРМ в комплекте ЗСУ | НПП ПромАВ, Казань |  |  |  |  |  |  | 4596 | 2023-10-01
b8X251 | Защитно-сигнализирующее утройство горелки 5 | ЗСУ-ПИ-60-700-01 | НПП ПромАВ, Казань
b8X252 | Датчик пламени ЗСУ горелки 5 | ЛУЧ-КЭ-Щ в комплекте ЗСУ | НПП ПромАВ, Казань |  |  |  |  |  |  | 10020 | 2023-10-01
b8X253 | Источник высокого напряжения ЗСУ горелки 5 | ИВН-ТРМ в комплекте ЗСУ | НПП ПромАВ, Казань |  |  |  |  |  |  | 4596 | 2023-10-01
b8X261 | Защитно-сигнализирующее утройство горелки 6 | ЗСУ-ПИ-60-700-01 | НПП ПромАВ, Казань
b8X262 | Датчик пламени ЗСУ горелки 6 | ЛУЧ-КЭ-Щ в комплекте ЗСУ | НПП ПромАВ, Казань |  |  |  |  |  |  | 10020 | 2023-10-01
b8X263 | Источник высокого напряжения ЗСУ горелки 6 | ИВН-ТРМ в комплекте ЗСУ | НПП ПромАВ, Казань |  |  |  |  |  |  | 4596 | 2023-10-01
w8dPt011 | Перепад давления теплоносителя на диафрагме после котла | Преобразователь давления измерительный АИР-20/М2/-/Н//ДД/440/-/-/11V/А3И1/t4070/А00/0...63кПа/10МПа/42/ШР-14/К1+/IP65/КР3/-/Y(С30)/KKS/ГП/ТУ; Блок клапанный ЭЛЕМЕР-БК/С/3/0/-/02/03/Р5/t4070 У3/ДР/М20УМ/- | Элемер, Зеленоград МО | 0 | 63 | кПа |  |  | 6 | 132470 | 2024-04-22
w8Te012 | Температура теплоносителя после котла | Термопреобразователь сопротивления ТС-1088/-/1/-/50М/-50…+200°С/250/10/С/АГ-10/С/Сх.№2/ГП/ЭП | Элемер, Зеленоград МО | -50 | 200 | град.С |  |  | 0.8 | 4840 | 2024-04-22
w8Tg012 | Температура теплоносителя после котла | Термометр биметаллический ТБ-2Р(0…200)-1,5-250-10-М20 ТУ 311-00225621.160-96 | Теплоконтроль, Казань | 0 | 200 | град.С
w8Te013 | Температура теплоносителя после котла (дубль) | Термопреобразователь сопротивления ТС-1088/-/1/-/50М/-50…+200°С/250/10/С/АГ-10/С/Сх.№2/ГП/ЭП | Элемер, Зеленоград МО | -50 | 200 | град.С |  |  | 0.8 | 4840 | 2024-04-22
w8Pt014 | Давление теплоносителя после котла | Преобразователь давления измерительный АИР-20/М2/-/Н//ДИ/160/-/М20/11N/А3И1/t4070/А00/0...1,6МПа/42/ШР-14/К1+/IP65/КР2/Т7ФУ/-/KKS/ГП/ТУ | Элемер, Зеленоград МО | 0 | 1.6 | Мпа |  |  | 2 | 76895 | 2024-04-22
w8Psg014 | ЭКМ на трубопроводе воды после котла | Электроконтактный манометр ЭКМ 2005/-/ДИ/ИМ1,6М/1,6/МПа/D/V/А16И1/t0550/24/-/GSP/М20/11N/-/ГП/ЭП | Элемер, Зеленоград МО | 0 | 1.6 | МПа |  |  |  | 55450 | 2024-04-22
w8Pt021 | Давление теплоносителя до котла | Преобразователь давления измерительный АИР-20/М2/-/Н//ДИ/160/-/М20/11N/А3И1/t4070/А00/0...1,6МПа/42/ШР-14/К1+/IP65/КР2/Т7ФУ/-/KKS/ГП/ТУ | Элемер, Зеленоград МО | 0 | 1.6 | Мпа |  |  | 2 | 76895 | 2024-04-22
w8Pg021 | Давление теплоносителя до котла | Манометр показывающий МП4-У У2; 0-1,6 МПа кл.1,0 160мм | Манотомь, Томск | 0 | 1.6 | МПа
w8Te022 | Температура теплоносителя до котла | Термопреобразователь сопротивления ТС-1088/-/1/-/50М/-50…+200°С/250/10/С/АГ-10/С/Сх.№2/ГП/ЭП | Элемер, Зеленоград МО | -50 | 200 | град.С |  |  | 0.8 | 4840 | 2024-04-22
w8Tg022 | Температура теплоносителя до котла | Термометр биметаллический ТБ-2Р(0…200)-1,5-250-10-М20 ТУ 311-00225621.160-96 | Теплоконтроль, Казань | 0 | 200 | град.С
х8СН001 | Датчик контроля загазованности по метану | ДАК-СН4-027 | Аналитприбор, Смоленск
х8СН002 | Датчик контроля загазованности по метану | ДАК-СН4-027 | Аналитприбор, Смоленск
х8СН003 | Датчик контроля загазованности по метану | ДАК-СН4-027 | Аналитприбор, Смоленск
х8СО001 | Датчик контроля загазованности по СО | ДАХ-М-05-СО-200 | Аналитприбор, Смоленск
х8СО002 | Датчик контроля загазованности по СО | ДАХ-М-05-СО-200 | Аналитприбор, Смоленск

Sheet: 240426кор
шифр | назначение | наименование | производитель | предел от | предел до | ед.изм | Ду | эн.потр | масса | цена без НДС | дата цены | схема эл. | схема монт. | параметры схем
g8V001 | Клапан НЗ продувки между задвижками | КМГ-50Ф-100 | Теплотехника, Переяславль-Залесский |  | 100 |  | 50 |  | 5.4 | 20590 | 2024-04-22
g8M002 | Задвижка общекотловая | 30с 941нж с электроприводом ГЗ-Б.300/24, 380В | Южноураларматура, Миасс |  | 1600 |  | 200 |  | 127 | 234720 | 2024-04-22
g8V001 | Клапан НЗ продувки газопровода перед ГОК | КМГ-50Ф-100 | Теплотехника, Переяславль-Залесский |  | 100 |  | 50 |  | 5.4 | 20590 | 2024-04-22
g8V003 | Главный ПЗК НЗ котла | КМГ-200Ф-100 | Теплотехника, Переяславль-Залесский |  | 100 |  | 200 |  | 79.0 | 191490 | 2024-04-22
g8sM004 | Заслонка общекотловая | ЗГД-150ФМ3-600, привод МЭОФ | Теплотехника, Переяславль-Залесский |  | 600 |  | 150 |  | 15.0 | 30910 | 2024-04-22
g8V005 | Клапан НЗ продувки газопровода из тупика | КМГ-50Ф-100 | Теплотехника, Переяславль-Залесский |  | 100 |  | 50 |  | 5.4 | 20590 | 2024-04-22
g8V101 | ПЗК1 НЗ группы горелок 1 | КМГ-150Ф-100 | Теплотехника, Переяславль-Залесский |  | 100 |  | 150 |  | 64.0 | 120720 | 2024-04-22
g8V201 | ПЗК1 НЗ группы горелок 2 | КМГ-150Ф-100 | Теплотехника, Переяславль-Залесский |  | 100 |  | 150 |  | 64.0 | 120720 | 2024-04-22
g8V111 | ПЗК2 НЗ горелки 1 | КМГ-100ФР-100 | Теплотехника, Переяславль-Залесский |  | 100 |  | 100 |  | 17.6 | 51300 | 2024-04-22
g8V121 | ПЗК2 НЗ горелки 2 | КМГ-100ФР-100 | Теплотехника, Переяславль-Залесский |  | 100 |  | 100 |  | 17.6 | 51300 | 2024-04-22
g8V131 | ПЗК2 НЗ горелки 3 | КМГ-100ФР-100 | Теплотехника, Переяславль-Залесский |  | 100 |  | 100 |  | 17.6 | 51300 | 2024-04-22
g8V241 | ПЗК2 НЗ горелки 4 | КМГ-100ФР-100 | Теплотехника, Переяславль-Залесский |  | 100 |  | 100 |  | 17.6 | 51300 | 2024-04-22
g8V251 | ПЗК2 НЗ горелки 5 | КМГ-100ФР-100 | Теплотехника, Переяславль-Залесский |  | 100 |  | 100 |  | 17.6 | 51300 | 2024-04-22
g8V251 | ПЗК2 НЗ горелки 6 | КМГ-100ФР-100 | Теплотехника, Переяславль-Залесский |  | 100 |  | 100 |  | 17.6 | 51300 | 2024-04-22
g8V102 | Клапан НЗ опрессовки группы горелок 1 | КМГ-20-100 | Теплотехника, Переяславль-Залесский |  | 100 |  | 20 |  | 2.8 | 11540 | 2024-04-22
g8V202 | Клапан НЗ опрессовки группы горелок 2 | КМГ-20-100 | Теплотехника, Переяславль-Залесский |  | 100 |  | 20 |  | 2.8 | 11540 | 2024-04-22
g8V103 | Клапан НО безопасности группы горелок 1 | КМГ-20НО-100 | Теплотехника, Переяславль-Залесский |  | 100 |  | 20 |  | 2.6 | 14210 | 2024-04-22
g8V203 | Клапан НО безопасности группы горелок 2 | КМГ-20НО-100 | Теплотехника, Переяславль-Залесский |  | 100 |  | 20 |  | 2.6 | 14210 | 2024-04-22
g8V113 | Клапан НЗ запальника горелки 1 | КМГ-20-100 | Теплотехника, Переяславль-Залесский |  | 100 |  | 20 |  | 2.8 | 11540 | 2024-04-22
g8V123 | Клапан НЗ запальника горелки 2 | КМГ-20-100 | Теплотехника, Переяславль-Залесский |  | 100 |  | 20 |  | 2.8 | 11540 | 2024-04-22
g8V133 | Клапан НЗ запальника горелки 3 | КМГ-20-100 | Теплотехника, Переяславль-Залесский |  | 100 |  | 20 |  | 2.8 | 11540 | 2024-04-22
g8V243 | ПЗККлапан | КМГ-20-100 | Теплотехника, Переяславль-Залесский |  | 100 |  | 20 |  | 2.8 | 11540 | 2024-04-22
g8V253 | Клапан НЗ запальника горелки 5 | КМГ-20-100 | Теплотехника, Переяславль-Залесский |  | 100 |  | 20 |  | 2.8 | 11540 | 2024-04-22
g8V263 | Клапан НЗ запальника горелки 6 | КМГ-20-100 | Теплотехника, Переяславль-Залесский |  | 100 |  | 20 |  | 2.8 | 11540 | 2024-04-22
g8sM112 | Заслонка горелки 1 | ЗГД-100ФМ3-600, привод МЭОФ | Теплотехника, Переяславль-Залесский |  | 600 |  | 100 |  | 6.7 | 25200 | 2024-04-22
g8sM122 | Заслонка горелки 2 | ЗГД-100ФМ3-600, привод МЭОФ | Теплотехника, Переяславль-Залесский |  | 600 |  | 100 |  | 6.7 | 25200 | 2024-04-22
g8sM132 | Заслонка горелки 3 | ЗГД-100ФМ3-600, привод МЭОФ | Теплотехника, Переяславль-Залесский |  | 600 |  | 100 |  | 6.7 | 25200 | 2024-04-22
g8sM242 | Заслонка горелки 4 | ЗГД-100ФМ3-600, привод МЭОФ | Теплотехника, Переяславль-Залесский |  | 600 |  | 100 |  | 6.7 | 25200 | 2024-04-22
g8sM252 | Заслонка горелки 5 | ЗГД-100ФМ3-600, привод МЭОФ | Теплотехника, Переяславль-Залесский |  | 600 |  | 100 |  | 6.7 | 25200 | 2024-04-22
g8sM262 | Заслонка горелки 6 | ЗГД-100ФМ3-600, привод МЭОФ | Теплотехника, Переяславль-Залесский |  | 600 |  | 100 |  | 6.7 | 25200 | 2024-04-22
g8Pt101 | Давление между клапанов группы горелок 1 | Преобразователь давления измерительный АИР-10/-/SH/ДИ/1130/-/-/0...60кПа/C05/АГ-15И/М20/11N/t4070/42/IP65/PGM/-/-/-/-/-/-/KKS/-/-/-/ГП/ТУ | Элемер, Зеленоград МО | 0 | 60 | кПа |  |  | 2 | 43680 | 2024-04-22
g8Pt201 | Давление между клапанов группы горелок 2 | Преобразователь давления измерительный АИР-10/-/SH/ДИ/1130/-/-/0...60кПа/C05/АГ-15И/М20/11N/t4070/42/IP65/PGM/-/-/-/-/-/-/KKS/-/-/-/ГП/ТУ | Элемер, Зеленоград МО | 0 | 60 | кПа |  |  | 2 | 43680 | 2024-04-22
g8Pt001 | Давление газа перед общекотловой заслонкой | Преобразователь давления измерительный АИР-20/М2/-/Н//ДИ/130/-/М20/11N/А3И1/t4070/А00/0...60кПа/42/ШР-14/К1+/IP65/КР2/Т7ФУ/-/KKS/ГП/ТУ | Элемер, Зеленоград МО | 0 | 60 | кПа |  |  | 2 | 76895 | 2024-04-22
g8Pt002 | Давление газа перед общекотловой заслонкой | Преобразователь давления измерительный АИР-20/М2/-/Н//ДИ/120/-/М20/11N/А3И1/t4070/A01/0...40кПа/42/ШР-14/К1+/IP65/КР2/Т7ФУ/-/KKS/ГП/ТУ | Элемер, Зеленоград МО | 0 | 40 | кПа |  |  | 2 | 76245 | 2024-04-22
g8dPt003 | Перепад давление газа на диафрагме (расход) клапанным блоком | Преобразователь давления измерительный АИР-20/М2/-/Н//ДД/410/-/-/11V/А3И1/t4070/A01/0...6,3кПа/10МПа/42/ШР-14/К1+/IP65/КР3/-/Y(С30)/KKS/ГП/ТУ, Блок клапанный ЭЛЕМЕР-БК/С/3/0/-/02/03/Р5/t4070 У3/ДР/М20УМ/- | Элемер, Зеленоград МО | 0 | 6.3 | кПа |  |  | 6 | 132470 | 2024-04-22
g8Te001 | Температура газа перед котлом | Термопреобразователь сопротивления ТС-1088/-/1/-/50М/-50…+200°С/160/10/В/АГ-10/С/Сх.№2/ГП/ЭП | Элемер, Зеленоград МО | -50 | 200 | град.С |  |  | 0.8 | 4705 | 2024-04-22
a8Pt001 | Давление воздуха в общем коробе | Преобразователь давления измерительный АИР-20/М2/-/Н//ДИ/114/-/-/11V/А3И1/t4070/A01/0...2,5кПа/42/ШР-14/К1+/IP65/КР3/С5ФФ/-/KKS/ГП/ТУ | Элемер, Зеленоград МО | 0 | 2.5 | кПа |  |  | 2 | 115505 | 2024-04-22
a8Te001 | Температура воздуха в общем коробе | Термопреобразователь сопротивления ТС-1088/-/1/-/50М/-50…+200°С/400/10/В/АГ-10/С/Сх.№2/ГП/ЭП | Элемер, Зеленоград МО | -50 | 200 | град.С |  |  |  | 5060 | 2024-04-22
f8Pt001 | Разрежение в топке котла | Преобразователь давления измерительный АИР-20/М2/-/Н//ДИВ/304/-/-/11V/А3И1/t4070/B02/-0,2...2,0кПа/42/ШР-14/К1+/IP65/КР3/С5ФФ/-/KKS/ГП/ТУ | Элемер, Зеленоград МО | -0.2 | 0.2 | кПа |  |  | 5 | 118885 | 2024-04-22
f8Te001 | Температура дымовых газов за котлом | Термопреобразователь сопротивления ТС-1088/-/1/-/100П/–100…+450С/500/10/А/АГ-10/С/Сх.№2/ГП/ЭП | Элемер, Зеленоград МО | -100 | 450 | град.С |  |  | 0.8 | 5905 | 2024-04-22
w8Te001 | Температура теплоносителя до котла | Термопреобразователь сопротивления ТС-1088/-/1/-/50М/-50…+200°С/250/10/С/АГ-10/С/Сх.№2/ГП/ЭП | Элемер, Зеленоград МО | -50 | 200 | град.С |  |  | 0.8 | 4840 | 2024-04-22
w8TE002 | Температура теплоносителя до котла | Термопреобразователь сопротивления ТС-1088/-/1/-/50М/-50…+200°С/250/10/С/АГ-10/С/Сх.№2/ГП/ЭП | Элемер, Зеленоград МО | -50 | 200 | град.С |  |  | 0.8 | 4840 | 2024-04-22
w8TE003 | Температура теплоносителя до котла (дубль) | Термопреобразователь сопротивления ТС-1088/-/1/-/50М/-50…+200°С/250/10/С/АГ-10/С/Сх.№2/ГП/ЭП | Элемер, Зеленоград МО | -50 | 200 | град.С |  |  | 0.8 | 4840 | 2024-04-22
w8Pt001 | Давление теплоносителя до котла | Преобразователь давления измерительный АИР-20/М2/-/Н//ДИ/160/-/М20/11N/А3И1/t4070/А00/0...1,6МПа/42/ШР-14/К1+/IP65/КР2/Т7ФУ/-/KKS/ГП/ТУ | Элемер, Зеленоград МО | 0 | 1.6 | Мпа |  |  | 2 | 76895 | 2024-04-22
w8Pt002 | Давление теплоносителя после котла | Преобразователь давления измерительный АИР-20/М2/-/Н//ДИ/160/-/М20/11N/А3И1/t4070/А00/0...1,6МПа/42/ШР-14/К1+/IP65/КР2/Т7ФУ/-/KKS/ГП/ТУ | Элемер, Зеленоград МО | 0 | 1.6 | Мпа |  |  | 2 | 76895 | 2024-04-22
w8dPt001 | Перепад Давление теплоносителя на диафрагме | Преобразователь давления измерительный АИР-20/М2/-/Н//ДД/440/-/-/11V/А3И1/t4070/А00/0...63кПа/10МПа/42/ШР-14/К1+/IP65/КР3/-/Y(С30)/KKS/ГП/ТУ; Блок клапанный ЭЛЕМЕР-БК/С/3/0/-/02/03/Р5/t4070 У3/ДР/М20УМ/- | Элемер, Зеленоград МО | 0 | 63 | кПа |  |  | 6 | 132470 | 2024-04-22
w8Psg001 | ЭКМ на трубопроводе воды за котлом | Электроконтактный манометр ЭКМ 2005/-/ДИ/ИМ1,6М/1,6/МПа/D/V/А16И1/t0550/24/-/GSP/М20/11N/-/ГП/ЭП | Элемер, Зеленоград МО | 0 | 1.6 | МПа |  |  |  | 55450 | 2024-04-22
g8Pg001 | Давление газа между задвижками | Манометр показывающий МП4-У У2; 0-60 кПа кл.1,0 160мм | Манотомь, Томск | 0 | 60 | кПа
g8Pg002 | Давление газа перед главным отсекающим клапаном | Манометр показывающий МП4-У У2; 0-60 кПа кл.1,0 160мм | Манотомь, Томск | 0 | 60 | кПа
g8Pg003 | Давление газа до общей заслонки газа | Манометр показывающий МП4-У У2; 0-60 кПа кл.1,0 160мм | Манотомь, Томск | 0 | 60 | кПа
g8Pg004 | Давление газа после общей заслонки газа | Манометр показывающий МП4-У У2; 0-60 кПа кл.1,0 160мм | Манотомь, Томск | 0 | 60 | кПа
g8Pg101 | Давление газа перед группой горелок 1 | Напоромер мембранный НМП-100- М1Р-40кПа. ТУ-25-7305.016-90 | Саранский приборострительный завод | 0 | 40 | кПа
g8Pg201 | Давление газа перед группой горелок 2 | Напоромер мембранный НМП-100- М1Р-40кПа. ТУ-25-7305.016-90 | Саранский приборострительный завод | 0 | 40 | кПа
g8Pt111 | Давление газа перед горелкой 1 | Напоромер мембранный НМП-52-М2- 40кПа-1,5- У3 | Саранский приборострительный завод | 0 | 40 | кПа
g8Pt121 | Давление газа перед горелкой 2 | Напоромер мембранный НМП-52-М2- 40кПа-1,5- У3 | Саранский приборострительный завод | 0 | 40 | кПа
g8Pt131 | Давление газа перед горелкой 3 | Напоромер мембранный НМП-52-М2- 40кПа-1,5- У3 | Саранский приборострительный завод | 0 | 40 | кПа
g8Pt241 | Давление газа перед горелкой 4 | Напоромер мембранный НМП-52-М2- 40кПа-1,5- У3 | Саранский приборострительный завод | 0 | 40 | кПа
g8Pt251 | Давление газа перед горелкой 5 | Напоромер мембранный НМП-52-М2- 40кПа-1,5- У3 | Саранский приборострительный завод | 0 | 40 | кПа
g8Pt261 | Давление газа перед горелкой 6 | Напоромер мембранный НМП-52-М2- 40кПа-1,5- У3 | Саранский приборострительный завод | 0 | 40 | кПа
g8Ps001 | Давление газа после заслонки котла (Рмин) | Датчик-реле DG30В-3 0,25…3 кПа G.Kromschroeder. | Волгатерм, Нижний Новгород | 0.25 | 3 | кПа |  |  | 0.3 | 25961 | сайт
g8Ps002 | Давление газа после заслонки котла (Рмакс) | Датчик-реле DG500В-3 10…50 кПа G.Kromschroeder. | Волгатерм, Нижний Новгород | 10 | 50 | кПа |  |  | 0.3 | 27938 | сайт
a8Pg111 | Давление воздуха перед горелкой 1 | Напоромер мембранный НМП-52-М2- 2,5кПа-1,5- У3 | Саранский приборострительный завод | 0 | 2.5 | кПа
a8Pg121 | Давление воздуха перед горелкой 2 | Напоромер мембранный НМП-52-М2- 2,5кПа-1,5- У3 | Саранский приборострительный завод | 0 | 2.5 | кПа
a8Pg131 | Давление воздуха перед горелкой 3 | Напоромер мембранный НМП-52-М2- 2,5кПа-1,5- У3 | Саранский приборострительный завод | 0 | 2.5 | кПа
a8Pg241 | Давление воздуха перед горелкой 4 | Напоромер мембранный НМП-52-М2- 2,5кПа-1,5- У3 | Саранский приборострительный завод | 0 | 2.5 | кПа
a8Pg251 | Давление воздуха перед горелкой 5 | Напоромер мембранный НМП-52-М2- 2,5кПа-1,5- У3 | Саранский приборострительный завод | 0 | 2.5 | кПа
a8Pg261 | Давление воздуха перед горелкой 6 | Напоромер мембранный НМП-52-М2- 2,5кПа-1,5- У3 | Саранский приборострительный завод | 0 | 2.5 | кПа
a8Ps111 | Давление воздуха перед горелкой 1 (Рмин) | Датчик-реле DG10А-31 0,1…1 кПа G.Kromschroeder. | Волгатерм, Нижний Новгород | 0.1 | 1 | кПа |  |  | 0.3 | 25059 | сайт
a8Ps121 | Давление воздуха перед горелкой 2 (Рмин) | Датчик-реле DG10А-31 0,1…1 кПа G.Kromschroeder. | Волгатерм, Нижний Новгород | 0.1 | 1 | кПа |  |  | 0.3 | 25059 | сайт
a8Ps131 | Давление воздуха перед горелкой 3 (Рмин) | Датчик-реле DG10А-31 0,1…1 кПа G.Kromschroeder. | Волгатерм, Нижний Новгород | 0.1 | 1 | кПа |  |  | 0.3 | 25059 | сайт
a8Ps241 | Давление воздуха перед горелкой 4 (Рмин) | Датчик-реле DG10А-31 0,1…1 кПа G.Kromschroeder. | Волгатерм, Нижний Новгород | 0.1 | 1 | кПа |  |  | 0.3 | 25059 | сайт
a8Ps251 | Давление воздуха перед горелкой 5 (Рмин) | Датчик-реле DG10А-31 0,1…1 кПа G.Kromschroeder. | Волгатерм, Нижний Новгород | 0.1 | 1 | кПа |  |  | 0.3 | 25059 | сайт
a8Ps261 | Давление воздуха перед горелкой 6 (Рмин) | Датчик-реле DG10А-31 0,1…1 кПа G.Kromschroeder. | Волгатерм, Нижний Новгород | 0.1 | 1 | кПа |  |  | 0.3 | 25059 | сайт
a8Pg101 | Давления воздуха после вентилятора группы горелок 1 | Напоромер мембранный НМП-52-М2- 2,5кПа-1,5- У3 | Саранский приборострительный завод | 0 | 2.5 | кПа
a8Pg201 | Давления воздуха после вентилятора группы горелок 2 | Напоромер мембранный НМП-52-М2- 2,5кПа-1,5- У3 | Саранский приборострительный завод | 0 | 2.5 | кПа
a8Pg001 | Давления воздуха в общем коллекторе | Напоромер мембранный НМП-52-М2- 2,5кПа-1,5- У3 | Саранский приборострительный завод | 0 | 2.5 | кПа
f8Pg001 | Разрежение в топке котла | Тягонапоромер мембранный ТНМП-100-М1- ±0,125кПа-1,5- У3 | Саранский приборострительный завод | -0.125 | 0.125 | кПа
f8Ps001 | Разрежение в топке котла (мин разреж) | Датчик-реле DL1,5A-3Z -50…150 Па G.Kromschroeder. | Волгатерм, Нижний Новгород | -50 | 150 | Па |  |  | 0.3 | 27400 | сайт
f8Pg002 | Разрежение перед дымососом | Тягонапоромер мембранный ТмМП-52-М2- 0,6кПа..0-1,5- У3 | Саранский приборострительный завод | -0.6 | 0 | кПа
w8Tg001 | Температура теплоносителя до котла | Термометр биметаллический ТБ-2Р(0…200)-1,5-250-10-М20 ТУ 311-00225621.160-96 | Теплоконтроль, Казань | 0 | 200 | град.С
w8Tg002 | Температура теплоносителя после котла | Термометр биметаллический ТБ-2Р(0…200)-1,5-250-10-М20 ТУ 311-00225621.160-96 | Теплоконтроль, Казань | 0 | 200 | град.С
w8Pg001 | Давление теплоносителя до котла | Манометр показывающий МП4-У У2; 0-1,6 МПа кл.1,0 160мм | Манотомь, Томск | 0 | 1.6 | МПа
w8Pg002 | Давление теплоносителя после котла | Манометр показывающий МП4-У У2; 0-1,6 МПа кл.1,0 160мм | Манотомь, Томск | 0 | 1.6 | МПа
a8sM111 | Шибер воздуха горелки 1 | МЭО-100/25-0,25У-08 | СКБ СПА, Чебоксары
a8sM121 | Шибер воздуха горелки 2 | МЭО-100/25-0,25У-08 | СКБ СПА, Чебоксары
a8sM131 | Шибер воздуха горелки 3 | МЭО-100/25-0,25У-08 | СКБ СПА, Чебоксары
a8sM241 | Шибер воздуха горелки 4 | МЭО-100/25-0,25У-08 | СКБ СПА, Чебоксары
a8sM251 | Шибер воздуха горелки 5 | МЭО-100/25-0,25У-08 | СКБ СПА, Чебоксары
a8sM261 | Шибер воздуха горелки 6 | МЭО-100/25-0,25У-08 | СКБ СПА, Чебоксары
a8sM101 | Шибер воздуха вентилятора группы горелок 1 | МЭО-250/63-0,25У-08К | СКБ СПА, Чебоксары
a8sM201 | Шибер воздуха вентилятора группы горелок 2 | МЭО-250/63-0,25У-08К | СКБ СПА, Чебоксары
f8sM001 | Шибер дымососа | МЭО-630/63-0,25У-08К | СКБ СПА, Чебоксары
b8X111 | Защитно-сигнализирующее утройство горелки 1 | ЗСУ-ПИ-60-700-05 в комплекте | НПП ПромАВ, Казань
b8X112 | Датчик пламени ЗСУ горелки 1 | ЛУЧ-КЭ-Щ | НПП ПромАВ, Казань |  |  |  |  |  |  | 10020 | 2023-10-01
b8X113 | Источник высокого напряжения ЗСУ горелки 1 | ИВН-ТРМ | НПП ПромАВ, Казань |  |  |  |  |  |  | 4596 | 2023-10-01
b8X101 | Датчик пламени растопочой горелки группы горелок 1 | ФДСА-03М-01, узел монтажный и фланец к нему | НПП ПромАВ, Казань |  |  |  |  |  |  | 42192 | 2023-10-01
b8X121 | Защитно-сигнализирующее утройство горелки 2 | ЗСУ-ПИ-60-700-01 | НПП ПромАВ, Казань
b8X122 | Датчик пламени ЗСУ горелки 2 | ЛУЧ-КЭ-Щ в комплекте ЗСУ | НПП ПромАВ, Казань |  |  |  |  |  |  | 10020 | 2023-10-01
b8X123 | Источник высокого напряжения ЗСУ горелки 2 | ИВН-ТРМ в комплекте ЗСУ | НПП ПромАВ, Казань |  |  |  |  |  |  | 4596 | 2023-10-01
b8X131 | Защитно-сигнализирующее утройство горелки 3 | ЗСУ-ПИ-60-700-01 | НПП ПромАВ, Казань
b8X132 | Датчик пламени ЗСУ горелки 3 | ЛУЧ-КЭ-Щ в комплекте ЗСУ | НПП ПромАВ, Казань |  |  |  |  |  |  | 10020 | 2023-10-01
b8X133 | Источник высокого напряжения ЗСУ горелки 3 | ИВН-ТРМ в комплекте ЗСУ | НПП ПромАВ, Казань |  |  |  |  |  |  | 4596 | 2023-10-01
b8X241 | Защитно-сигнализирующее утройство горелки 4 | ЗСУ-ПИ-60-700-01 | НПП ПромАВ, Казань
b8X242 | Датчик пламени ЗСУ горелки 4 | ЛУЧ-КЭ-Щ в комплекте ЗСУ | НПП ПромАВ, Казань |  |  |  |  |  |  | 10020 | 2023-10-01
b8X243 | Источник высокого напряжения ЗСУ горелки 4 | ИВН-ТРМ в комплекте ЗСУ | НПП ПромАВ, Казань |  |  |  |  |  |  | 4596 | 2023-10-01
b8X251 | Защитно-сигнализирующее утройство горелки 5 | ЗСУ-ПИ-60-700-01 | НПП ПромАВ, Казань
b8X252 | Датчик пламени ЗСУ горелки 5 | ЛУЧ-КЭ-Щ в комплекте ЗСУ | НПП ПромАВ, Казань |  |  |  |  |  |  | 10020 | 2023-10-01
b8X253 | Источник высокого напряжения ЗСУ горелки 5 | ИВН-ТРМ в комплекте ЗСУ | НПП ПромАВ, Казань |  |  |  |  |  |  | 4596 | 2023-10-01
b8X261 | Защитно-сигнализирующее утройство горелки 6 | ЗСУ-ПИ-60-700-01 | НПП ПромАВ, Казань
b8X262 | Датчик пламени ЗСУ горелки 6 | ЛУЧ-КЭ-Щ в комплекте ЗСУ | НПП ПромАВ, Казань |  |  |  |  |  |  | 10020 | 2023-10-01
b8X263 | Источник высокого напряжения ЗСУ горелки 6 | ИВН-ТРМ в комплекте ЗСУ | НПП ПромАВ, Казань |  |  |  |  |  |  | 4596 | 2023-10-01
b8X101 | Датчик пламени растопочной горелки 1 группы горелок 1 | ФДСА-03М-01, узел монтажный и фланец к нему | НПП ПромАВ, Казань |  |  |  |  |  |  | 42192 | 2023-10-01
b8X201 | Датчик пламени растопочной горелки 6 группы горелок 2 | ФДСА-03М-01, узел монтажный и фланец к нему | НПП ПромАВ, Казань |  |  |  |  |  |  | 42192 | 2023-10-01

Sheet: 240424кор
шифр | назначение | наименование | производитель | предел от | предел до | ед.изм | Ду | эн.потр | масса | цена без НДС | дата цены | схема эл. | схема монт. | параметры схем
g8V001 | ПЗК НЗ продувки между задвижками | КМГ-50Ф-100 | Теплотехника, Переяславль-Залесский |  | 100 |  | 50 |  | 5.4 | 20590 | 2024-04-22 | было обозначение с нулями на конце
g8M002 | Задвижка общекотловая | 30с 941нж с электроприводом ГЗ-Б.300/24, 380В | Южноураларматура, Миасс |  | 1600 |  | 200 |  | 127 | 234720 | 2024-04-22
g8V003 | Главный ПЗК НЗ котла | КМГ-200Ф-100 | Теплотехника, Переяславль-Залесский |  | 100 |  | 200 |  | 79.0 | 191490 | 2024-04-22
g8sM004 | Заслонка общекотловая | ЗГД-150ФМ3-600, привод МЭОФ | Теплотехника, Переяславль-Залесский |  | 600 |  | 150 |  | 15.0 | 30910 | 2024-04-22 | дубль внизу убрал
g8V101 | ПЗК НЗ группы горелок 1 | КМГ-150Ф-100 | Теплотехника, Переяславль-Залесский |  | 100 |  | 150 |  | 64.0 | 120720 | 2024-04-22
g8V201 | ПЗК НЗ группы горелок 2 | КМГ-150Ф-100 | Теплотехника, Переяславль-Залесский |  | 100 |  | 150 |  | 64.0 | 120720 | 2024-04-22
g8V111 | ПЗК НЗ горелки 1 | КМГ-100ФР-100 | Теплотехника, Переяславль-Залесский |  | 100 |  | 100 |  | 17.6 | 51300 | 2024-04-22
g8V121 | ПЗК НЗ горелки 2 | КМГ-100ФР-100 | Теплотехника, Переяславль-Залесский |  | 100 |  | 100 |  | 17.6 | 51300 | 2024-04-22
g8V131 | ПЗК НЗ горелки 3 | КМГ-100ФР-100 | Теплотехника, Переяславль-Залесский |  | 100 |  | 100 |  | 17.6 | 51300 | 2024-04-22
g8V241 | ПЗК НЗ горелки 4 | КМГ-100ФР-100 | Теплотехника, Переяславль-Залесский |  | 100 |  | 100 |  | 17.6 | 51300 | 2024-04-22
g8V251 | ПЗК НЗ горелки 5 | КМГ-100ФР-100 | Теплотехника, Переяславль-Залесский |  | 100 |  | 100 |  | 17.6 | 51300 | 2024-04-22
g8V251 | ПЗК НЗ горелки 6 | КМГ-100ФР-100 | Теплотехника, Переяславль-Залесский |  | 100 |  | 100 |  | 17.6 | 51300 | 2024-04-22
g8V102 | ПЗК НЗ опрессовки группы горелок 1 | КМГ-20-100 | Теплотехника, Переяславль-Залесский |  | 100 |  | 20 |  | 2.8 | 11540 | 2024-04-22
g8V202 | ПЗК НЗ опрессовки группы горелок 2 | КМГ-20-100 | Теплотехника, Переяславль-Залесский |  | 100 |  | 20 |  | 2.8 | 11540 | 2024-04-22
g8V103 | ПЗК НО безопасности группы горелок 1 | КМГ-20НО-100 | Теплотехника, Переяславль-Залесский |  | 100 |  | 20 |  | 2.6 | 14210 | 2024-04-22
g8V203 | ПЗК НО безопасности группы горелок 2 | КМГ-20НО-100 | Теплотехника, Переяславль-Залесский |  | 100 |  | 20 |  | 2.6 | 14210 | 2024-04-22
g8V104 | ПЗК НЗпродувки группы горелок 1 | КМГ-50Ф-100 | Теплотехника, Переяславль-Залесский |  | 100 |  | 50 |  | 5.4 | 20590 | 2024-04-22 | Были другие номера
g8V204 | ПЗК НЗпродувки группы горелок 2 | КМГ-50Ф-100 | Теплотехника, Переяславль-Залесский |  | 100 |  | 50 |  | 5.4 | 20590 | 2024-04-22
g8V113 | ПЗК НЗ запальника горелки 1 | КМГ-20-100 | Теплотехника, Переяславль-Залесский |  | 100 |  | 20 |  | 2.8 | 11540 | 2024-04-22
g8V123 | ПЗК НЗ запальника горелки 2 | КМГ-20-100 | Теплотехника, Переяславль-Залесский |  | 100 |  | 20 |  | 2.8 | 11540 | 2024-04-22
g8V133 | ПЗК НЗ запальника горелки 3 | КМГ-20-100 | Теплотехника, Переяславль-Залесский |  | 100 |  | 20 |  | 2.8 | 11540 | 2024-04-22
g8V243 | ПЗК НЗ запальника горелки 4 | КМГ-20-100 | Теплотехника, Переяславль-Залесский |  | 100 |  | 20 |  | 2.8 | 11540 | 2024-04-22
g8V253 | ПЗК НЗ запальника горелки 5 | КМГ-20-100 | Теплотехника, Переяславль-Залесский |  | 100 |  | 20 |  | 2.8 | 11540 | 2024-04-22
g8V263 | ПЗК НЗ запальника горелки 6 | КМГ-20-100 | Теплотехника, Переяславль-Залесский |  | 100 |  | 20 |  | 2.8 | 11540 | 2024-04-22
g8sM112 | Заслонка горелки 1 | ЗГД-100ФМ3-600, привод МЭОФ | Теплотехника, Переяславль-Залесский |  | 600 |  | 100 |  | 6.7 | 25200 | 2024-04-22 | дубли внизу убрал
g8sM122 | Заслонка горелки 2 | ЗГД-100ФМ3-600, привод МЭОФ | Теплотехника, Переяславль-Залесский |  | 600 |  | 100 |  | 6.7 | 25200 | 2024-04-22
g8sM132 | Заслонка горелки 3 | ЗГД-100ФМ3-600, привод МЭОФ | Теплотехника, Переяславль-Залесский |  | 600 |  | 100 |  | 6.7 | 25200 | 2024-04-22
g8sM242 | Заслонка горелки 4 | ЗГД-100ФМ3-600, привод МЭОФ | Теплотехника, Переяславль-Залесский |  | 600 |  | 100 |  | 6.7 | 25200 | 2024-04-22
g8sM252 | Заслонка горелки 5 | ЗГД-100ФМ3-600, привод МЭОФ | Теплотехника, Переяславль-Залесский |  | 600 |  | 100 |  | 6.7 | 25200 | 2024-04-22
g8sM262 | Заслонка горелки 6 | ЗГД-100ФМ3-600, привод МЭОФ | Теплотехника, Переяславль-Залесский |  | 600 |  | 100 |  | 6.7 | 25200 | 2024-04-22
g8Pt101 | Давление между клапанов группы горелок 1 | Преобразователь давления измерительный АИР-10/-/SH/ДИ/1130/-/-/0...60кПа/C05/АГ-15И/М20/11N/t4070/42/IP65/PGM/-/-/-/-/-/-/KKS/-/-/-/ГП/ТУ | Элемер, Зеленоград МО | 0 | 60 | кПа |  |  | 2 | 43680 | 2024-04-22
g8Pt201 | Давление между клапанов группы горелок 2 | Преобразователь давления измерительный АИР-10/-/SH/ДИ/1130/-/-/0...60кПа/C05/АГ-15И/М20/11N/t4070/42/IP65/PGM/-/-/-/-/-/-/KKS/-/-/-/ГП/ТУ | Элемер, Зеленоград МО | 0 | 60 | кПа |  |  | 2 | 43680 | 2024-04-22
g8Pt111 | Давление газа перед горелкой 1 | Преобразователь давления измерительный АИР-10/-/SH/ДИ/1130/-/-/0...60кПа/C05/АГ-15И/М20/11N/t4070/42/IP65/PGM/-/-/-/-/-/-/KKS/-/-/-/ГП/ТУ | Элемер, Зеленоград МО | 0 | 60 | кПа |  |  | 2 | 43680 | 2024-04-22
g8Pt121 | Давление газа перед горелкой 2 | Преобразователь давления измерительный АИР-10/-/SH/ДИ/1130/-/-/0...60кПа/C05/АГ-15И/М20/11N/t4070/42/IP65/PGM/-/-/-/-/-/-/KKS/-/-/-/ГП/ТУ | Элемер, Зеленоград МО | 0 | 60 | кПа |  |  | 2 | 43680 | 2024-04-22
g8Pt131 | Давление газа перед горелкой 3 | Преобразователь давления измерительный АИР-10/-/SH/ДИ/1130/-/-/0...60кПа/C05/АГ-15И/М20/11N/t4070/42/IP65/PGM/-/-/-/-/-/-/KKS/-/-/-/ГП/ТУ | Элемер, Зеленоград МО | 0 | 60 | кПа |  |  | 2 | 43680 | 2024-04-22
g8Pt241 | Давление газа перед горелкой 4 | Преобразователь давления измерительный АИР-10/-/SH/ДИ/1130/-/-/0...60кПа/C05/АГ-15И/М20/11N/t4070/42/IP65/PGM/-/-/-/-/-/-/KKS/-/-/-/ГП/ТУ | Элемер, Зеленоград МО | 0 | 60 | кПа |  |  | 2 | 43680 | 2024-04-22
g8Pt251 | Давление газа перед горелкой 5 | Преобразователь давления измерительный АИР-10/-/SH/ДИ/1130/-/-/0...60кПа/C05/АГ-15И/М20/11N/t4070/42/IP65/PGM/-/-/-/-/-/-/KKS/-/-/-/ГП/ТУ | Элемер, Зеленоград МО | 0 | 60 | кПа |  |  | 2 | 43680 | 2024-04-22
g8Pt261 | Давление газа перед горелкой 6 | Преобразователь давления измерительный АИР-10/-/SH/ДИ/1130/-/-/0...60кПа/C05/АГ-15И/М20/11N/t4070/42/IP65/PGM/-/-/-/-/-/-/KKS/-/-/-/ГП/ТУ | Элемер, Зеленоград МО | 0 | 60 | кПа |  |  | 2 | 43680 | 2024-04-22
g8Pt001 | Давление газа перед общекотловой заслонкой | Преобразователь давления измерительный АИР-20/М2/-/Н//ДИ/130/-/М20/11N/А3И1/t4070/А00/0...60кПа/42/ШР-14/К1+/IP65/КР2/Т7ФУ/-/KKS/ГП/ТУ | Элемер, Зеленоград МО | 0 | 60 | кПа |  |  | 2 | 76895 | 2024-04-22 | они рядом стоят, почему
g8Pt002 | Давление газа перед общекотловой заслонкой | Преобразователь давления измерительный АИР-20/М2/-/Н//ДИ/120/-/М20/11N/А3И1/t4070/A01/0...40кПа/42/ШР-14/К1+/IP65/КР2/Т7ФУ/-/KKS/ГП/ТУ | Элемер, Зеленоград МО | 0 | 40 | кПа |  |  | 2 | 76245 | 2024-04-22 | перед горелками 60 тогда
g8dPt003 | Перепад давление газа на диафрагме (расход) клапанным блоком | Преобразователь давления измерительный АИР-20/М2/-/Н//ДД/410/-/-/11V/А3И1/t4070/A01/0...6,3кПа/10МПа/42/ШР-14/К1+/IP65/КР3/-/Y(С30)/KKS/ГП/ТУ, Блок клапанный ЭЛЕМЕР-БК/С/3/0/-/02/03/Р5/t4070 У3/ДР/М20УМ/- | Элемер, Зеленоград МО | 0 | 6.3 | кПа |  |  | 6 | 132470 | 2024-04-22
g8Te001 | Температура газа перед котлом | Термопреобразователь сопротивления ТС-1088/-/1/-/50М/-50…+200°С/160/10/В/АГ-10/С/Сх.№2/ГП/ЭП | Элемер, Зеленоград МО | -50 | 200 | град.С |  |  | 0.8 | 4705 | 2024-04-22
a8Pt001 | Давление воздуха в общем коробе | Преобразователь давления измерительный АИР-20/М2/-/Н//ДИ/114/-/-/11V/А3И1/t4070/A01/0...2,5кПа/42/ШР-14/К1+/IP65/КР3/С5ФФ/-/KKS/ГП/ТУ | Элемер, Зеленоград МО | 0 | 2.5 | кПа |  |  | 2 | 115505 | 2024-04-22
a8Pt111 | Давление воздуха перед горелкой 1 | Преобразователь давления измерительный АИР-20/М2/-/Н//ДИ/114/-/-/11V/А3И1/t4070/A01/0...2,5кПа/42/ШР-14/К1+/IP65/КР3/С5ФФ/-/KKS/ГП/ТУ | Элемер, Зеленоград МО | 0 | 2.5 | кПа |  |  | 2 | 115505 | 2024-04-22
a8Pt121 | Давление воздуха перед горелкой 2 | Преобразователь давления измерительный АИР-20/М2/-/Н//ДИ/114/-/-/11V/А3И1/t4070/A01/0...2,5кПа/42/ШР-14/К1+/IP65/КР3/С5ФФ/-/KKS/ГП/ТУ | Элемер, Зеленоград МО | 0 | 2.5 | кПа |  |  | 2 | 115505 | 2024-04-22
a8Pt131 | Давление воздуха перед горелкой 3 | Преобразователь давления измерительный АИР-20/М2/-/Н//ДИ/114/-/-/11V/А3И1/t4070/A01/0...2,5кПа/42/ШР-14/К1+/IP65/КР3/С5ФФ/-/KKS/ГП/ТУ | Элемер, Зеленоград МО | 0 | 2.5 | кПа |  |  | 2 | 115505 | 2024-04-22
a8Pt241 | Давление воздуха перед горелкой 4 | Преобразователь давления измерительный АИР-20/М2/-/Н//ДИ/114/-/-/11V/А3И1/t4070/A01/0...2,5кПа/42/ШР-14/К1+/IP65/КР3/С5ФФ/-/KKS/ГП/ТУ | Элемер, Зеленоград МО | 0 | 2.5 | кПа |  |  | 2 | 115505 | 2024-04-22
a8Pt251 | Давление воздуха перед горелкой 5 | Преобразователь давления измерительный АИР-20/М2/-/Н//ДИ/114/-/-/11V/А3И1/t4070/A01/0...2,5кПа/42/ШР-14/К1+/IP65/КР3/С5ФФ/-/KKS/ГП/ТУ | Элемер, Зеленоград МО | 0 | 2.5 | кПа |  |  | 2 | 115505 | 2024-04-22
a8Pt261 | Давление воздуха перед горелкой 6 | Преобразователь давления измерительный АИР-20/М2/-/Н//ДИ/114/-/-/11V/А3И1/t4070/A01/0...2,5кПа/42/ШР-14/К1+/IP65/КР3/С5ФФ/-/KKS/ГП/ТУ | Элемер, Зеленоград МО | 0 | 2.5 | кПа |  |  | 2 | 115505 | 2024-04-22
a8Te001 | Температура воздуха в общем коробе | Термопреобразователь сопротивления ТС-1088/-/1/-/50М/-50…+200°С/400/10/В/АГ-10/С/Сх.№2/ГП/ЭП | Элемер, Зеленоград МО | -50 | 200 | град.С |  |  |  | 5060 | 2024-04-22
f8Pt001 | Разрежение в топке котла | Преобразователь давления измерительный АИР-20/М2/-/Н//ДИВ/304/-/-/11V/А3И1/t4070/B02/-0,2...2,0кПа/42/ШР-14/К1+/IP65/КР3/С5ФФ/-/KKS/ГП/ТУ | Элемер, Зеленоград МО | -0.2 | 0.2 | кПа |  |  | 5 | 118885 | 2024-04-22
f8Te001 | Температура дымовых газов за котлом | Термопреобразователь сопротивления ТС-1088/-/1/-/100П/–100…+450С/500/10/А/АГ-10/С/Сх.№2/ГП/ЭП | Элемер, Зеленоград МО | -100 | 450 | град.С |  |  | 0.8 | 5905 | 2024-04-22
w8Te001 | Температура теплоносителя до котла | Термопреобразователь сопротивления ТС-1088/-/1/-/50М/-50…+200°С/250/10/С/АГ-10/С/Сх.№2/ГП/ЭП | Элемер, Зеленоград МО | -50 | 200 | град.С |  |  | 0.8 | 4840 | 2024-04-22
w8TE002 | Температура теплоносителя до котла | Термопреобразователь сопротивления ТС-1088/-/1/-/50М/-50…+200°С/250/10/С/АГ-10/С/Сх.№2/ГП/ЭП | Элемер, Зеленоград МО | -50 | 200 | град.С |  |  | 0.8 | 4840 | 2024-04-22
w8TE003 | Температура теплоносителя до котла (дубль) | Термопреобразователь сопротивления ТС-1088/-/1/-/50М/-50…+200°С/250/10/С/АГ-10/С/Сх.№2/ГП/ЭП | Элемер, Зеленоград МО | -50 | 200 | град.С |  |  | 0.8 | 4840 | 2024-04-22
w8Pt001 | Давление теплоносителя до котла | Преобразователь давления измерительный АИР-20/М2/-/Н//ДИ/160/-/М20/11N/А3И1/t4070/А00/0...1,6МПа/42/ШР-14/К1+/IP65/КР2/Т7ФУ/-/KKS/ГП/ТУ | Элемер, Зеленоград МО | 0 | 1.6 | Мпа |  |  | 2 | 76895 | 2024-04-22
w8Pt002 | Давление теплоносителя после котла | Преобразователь давления измерительный АИР-20/М2/-/Н//ДИ/160/-/М20/11N/А3И1/t4070/А00/0...1,6МПа/42/ШР-14/К1+/IP65/КР2/Т7ФУ/-/KKS/ГП/ТУ | Элемер, Зеленоград МО | 0 | 1.6 | Мпа |  |  | 2 | 76895 | 2024-04-22
w8dPt001 | Перепад Давление теплоносителя на диафрагме | Преобразователь давления измерительный АИР-20/М2/-/Н//ДД/440/-/-/11V/А3И1/t4070/А00/0...63кПа/10МПа/42/ШР-14/К1+/IP65/КР3/-/Y(С30)/KKS/ГП/ТУ; Блок клапанный ЭЛЕМЕР-БК/С/3/0/-/02/03/Р5/t4070 У3/ДР/М20УМ/- | Элемер, Зеленоград МО | 0 | 63 | кПа |  |  | 6 | 132470 | 2024-04-22
w8Psg001 | ЭКМ на трубопроводе воды за котлом | Электроконтактный манометр ЭКМ 2005/-/ДИ/ИМ1,6М/1,6/МПа/D/V/А16И1/t0550/24/-/GSP/М20/11N/-/ГП/ЭП | Элемер, Зеленоград МО | 0 | 1.6 | МПа |  |  |  | 55450 | 2024-04-22
g8Pg001 | Давление газа между задвижками | Манометр показывающий МП4-У У2; 0-60 кПа кл.1,0 160мм | Манотомь, Томск | 0 | 60 | кПа
g8Pg002 | Давление газа перед главным отсекающим клапаном | Манометр показывающий МП4-У У2; 0-60 кПа кл.1,0 160мм | Манотомь, Томск | 0 | 60 | кПа
g8Pg003 | Давление газа до общей заслонки газа | Манометр показывающий МП4-У У2; 0-60 кПа кл.1,0 160мм | Манотомь, Томск | 0 | 60 | кПа
g8Pg004 | Давление газа после общей заслонки газа | Манометр показывающий МП4-У У2; 0-60 кПа кл.1,0 160мм | Манотомь, Томск | 0 | 60 | кПа
g8Pg101 | Давление газа перед группой горелок 1 | Напоромер мембранный НМП-100- М1Р-40кПа. ТУ-25-7305.016-90 | Саранский приборострительный завод | 0 | 40 | кПа
g8Pg201 | Давление газа перед группой горелок 2 | Напоромер мембранный НМП-100- М1Р-40кПа. ТУ-25-7305.016-90 | Саранский приборострительный завод | 0 | 40 | кПа
g8Pt111 | Давление газа перед горелкой 1 | Напоромер мембранный НМП-52-М2- 40кПа-1,5- У3 | Саранский приборострительный завод | 0 | 40 | кПа
g8Pt121 | Давление газа перед горелкой 2 | Напоромер мембранный НМП-52-М2- 40кПа-1,5- У3 | Саранский приборострительный завод | 0 | 40 | кПа
g8Pt131 | Давление газа перед горелкой 3 | Напоромер мембранный НМП-52-М2- 40кПа-1,5- У3 | Саранский приборострительный завод | 0 | 40 | кПа
g8Pt241 | Давление газа перед горелкой 4 | Напоромер мембранный НМП-52-М2- 40кПа-1,5- У3 | Саранский приборострительный завод | 0 | 40 | кПа
g8Pt251 | Давление газа перед горелкой 5 | Напоромер мембранный НМП-52-М2- 40кПа-1,5- У3 | Саранский приборострительный завод | 0 | 40 | кПа
g8Pt261 | Давление газа перед горелкой 6 | Напоромер мембранный НМП-52-М2- 40кПа-1,5- У3 | Саранский приборострительный завод | 0 | 40 | кПа
g8Ps001 | Давление газа после заслонки котла (Рмин) | Датчик-реле DG30В-3 0,25…3 кПа G.Kromschroeder. | Волгатерм, Нижний Новгород | 0.25 | 3 | кПа |  |  | 0.3 | 25961 | сайт | зачем реле давления?
g8Ps002 | Давление газа после заслонки котла (Рмакс) | Датчик-реле DG500В-3 10…50 кПа G.Kromschroeder. | Волгатерм, Нижний Новгород | 10 | 50 | кПа |  |  | 0.3 | 27938 | сайт | может лучше датчик?
a8Pg111 | Давление воздуха перед горелкой 1 | Напоромер мембранный НМП-52-М2- 2,5кПа-1,5- У3 | Саранский приборострительный завод | 0 | 2.5 | кПа
a8Pg121 | Давление воздуха перед горелкой 2 | Напоромер мембранный НМП-52-М2- 2,5кПа-1,5- У3 | Саранский приборострительный завод | 0 | 2.5 | кПа
a8Pg131 | Давление воздуха перед горелкой 3 | Напоромер мембранный НМП-52-М2- 2,5кПа-1,5- У3 | Саранский приборострительный завод | 0 | 2.5 | кПа
a8Pg241 | Давление воздуха перед горелкой 4 | Напоромер мембранный НМП-52-М2- 2,5кПа-1,5- У3 | Саранский приборострительный завод | 0 | 2.5 | кПа
a8Pg251 | Давление воздуха перед горелкой 5 | Напоромер мембранный НМП-52-М2- 2,5кПа-1,5- У3 | Саранский приборострительный завод | 0 | 2.5 | кПа
a8Pg261 | Давление воздуха перед горелкой 6 | Напоромер мембранный НМП-52-М2- 2,5кПа-1,5- У3 | Саранский приборострительный завод | 0 | 2.5 | кПа
a8Ps111 | Давление воздуха перед горелкой 1 (Рмин) | Датчик-реле DG10А-31 0,1…1 кПа G.Kromschroeder. | Волгатерм, Нижний Новгород | 0.1 | 1 | кПа |  |  | 0.3 | 25059 | сайт
a8Ps121 | Давление воздуха перед горелкой 2 (Рмин) | Датчик-реле DG10А-31 0,1…1 кПа G.Kromschroeder. | Волгатерм, Нижний Новгород | 0.1 | 1 | кПа |  |  | 0.3 | 25059 | сайт
a8Ps131 | Давление воздуха перед горелкой 3 (Рмин) | Датчик-реле DG10А-31 0,1…1 кПа G.Kromschroeder. | Волгатерм, Нижний Новгород | 0.1 | 1 | кПа |  |  | 0.3 | 25059 | сайт
a8Ps241 | Давление воздуха перед горелкой 4 (Рмин) | Датчик-реле DG10А-31 0,1…1 кПа G.Kromschroeder. | Волгатерм, Нижний Новгород | 0.1 | 1 | кПа |  |  | 0.3 | 25059 | сайт
a8Ps251 | Давление воздуха перед горелкой 5 (Рмин) | Датчик-реле DG10А-31 0,1…1 кПа G.Kromschroeder. | Волгатерм, Нижний Новгород | 0.1 | 1 | кПа |  |  | 0.3 | 25059 | сайт
a8Ps261 | Давление воздуха перед горелкой 6 (Рмин) | Датчик-реле DG10А-31 0,1…1 кПа G.Kromschroeder. | Волгатерм, Нижний Новгород | 0.1 | 1 | кПа |  |  | 0.3 | 25059 | сайт
a8Pg101 | Давления воздуха после вентилятора группы горелок 1 | Напоромер мембранный НМП-52-М2- 2,5кПа-1,5- У3 | Саранский приборострительный завод | 0 | 2.5 | кПа | изменил маркировку, привязал к группам горелок
a8Pg201 | Давления воздуха после вентилятора группы горелок 2 | Напоромер мембранный НМП-52-М2- 2,5кПа-1,5- У3 | Саранский приборострительный завод | 0 | 2.5 | кПа
a8Pg001 | Давления воздуха в общем коллекторе | Напоромер мембранный НМП-52-М2- 2,5кПа-1,5- У3 | Саранский приборострительный завод | 0 | 2.5 | кПа
f8Pg001 | Разрежение в топке котла | Тягонапоромер мембранный ТНМП-100-М1- ±0,125кПа-1,5- У3 | Саранский приборострительный завод | -0.125 | 0.125 | кПа
f8Ps001 | Разрежение в топке котла (мин разреж) | Датчик-реле DL1,5A-3Z -50…150 Па G.Kromschroeder. | Волгатерм, Нижний Новгород | -50 | 150 | Па |  |  | 0.3 | 27400 | сайт
f8Pg002 | Разрежение перед дымососом | Тягонапоромер мембранный ТмМП-52-М2- 0,6кПа..0-1,5- У3 | Саранский приборострительный завод | -0.6 | 0 | кПа
w8Tg001 | Температура теплоносителя до котла | Термометр биметаллический ТБ-2Р(0…200)-1,5-250-10-М20 ТУ 311-00225621.160-96 | Теплоконтроль, Казань | 0 | 200 | град.С
w8Tg002 | Температура теплоносителя после котла | Термометр биметаллический ТБ-2Р(0…200)-1,5-250-10-М20 ТУ 311-00225621.160-96 | Теплоконтроль, Казань | 0 | 200 | град.С
w8Pg001 | Давление теплоносителя до котла | Манометр показывающий МП4-У У2; 0-1,6 МПа кл.1,0 160мм | Манотомь, Томск | 0 | 1.6 | МПа
w8Pg002 | Давление теплоносителя после котла | Манометр показывающий МП4-У У2; 0-1,6 МПа кл.1,0 160мм | Манотомь, Томск | 0 | 1.6 | МПа
a8sM111 | Шибер воздуха горелки 1 | МЭО-100/25-0,25У-08 | СКБ СПА, Чебоксары | убрал дублирующие обозначание по газовым заслонкам
a8sM121 | Шибер воздуха горелки 2 | МЭО-100/25-0,25У-08 | СКБ СПА, Чебоксары | шифр sM вместо Ms поставил, не принципиально, но лучше так
a8sM131 | Шибер воздуха горелки 3 | МЭО-100/25-0,25У-08 | СКБ СПА, Чебоксары
a8sM241 | Шибер воздуха горелки 4 | МЭО-100/25-0,25У-08 | СКБ СПА, Чебоксары
a8sM251 | Шибер воздуха горелки 5 | МЭО-100/25-0,25У-08 | СКБ СПА, Чебоксары
a8sM261 | Шибер воздуха горелки 6 | МЭО-100/25-0,25У-08 | СКБ СПА, Чебоксары
a8sM101 | Шибер воздуха вентилятора группы горелок 1 | МЭО-250/63-0,25У-08К | СКБ СПА, Чебоксары
a8sM201 | Шибер воздуха вентилятора группы горелок 2 | МЭО-250/63-0,25У-08К | СКБ СПА, Чебоксары
f8sM001 | Шибер дымососа | МЭО-630/63-0,25У-08К | СКБ СПА, Чебоксары
b8X111 | Датчик пламени запальника горелки 1 | ЛУЧ-КЭ-Щ | НПП ПромАВ, Казань |  |  |  |  |  |  | 10020 | 2023-10-01
b8X121 | Датчик пламени запальника горелки 2 | ЛУЧ-КЭ-Щ | НПП ПромАВ, Казань |  |  |  |  |  |  | 10020 | 2023-10-01
b8X131 | Датчик пламени запальника горелки 3 | ЛУЧ-КЭ-Щ | НПП ПромАВ, Казань |  |  |  |  |  |  | 10020 | 2023-10-01
b8X241 | Датчик пламени запальника горелки 4 | ЛУЧ-КЭ-Щ | НПП ПромАВ, Казань |  |  |  |  |  |  | 10020 | 2023-10-01
b8X251 | Датчик пламени запальника горелки 5 | ЛУЧ-КЭ-Щ | НПП ПромАВ, Казань |  |  |  |  |  |  | 10020 | 2023-10-01
b8X261 | Датчик пламени запальника горелки 6 | ЛУЧ-КЭ-Щ | НПП ПромАВ, Казань |  |  |  |  |  |  | 10020 | 2023-10-01
 | Датчик пламени растопочной горелки | ФДСА-03М-01, узел монтажный и фланец к нему | НПП ПромАв, Казань |  |  |  |  |  |  | 42192 | 2023-10-01
 | Запально-сигнализирующее устройство | ЗСУ-ПИ-60-700 | НПП ПромАв, Казань |  |  |  |  |  |  |  | 2023-10-01
 | Источник высокого напряжения | ИВН-ТРМ | НПП ПромАв, Казань |  |  |  |  |  |  | 4596 | 2023-10-01
По горению надо определиться. Как я понял из разговора с местными, отдельный ФДСА не установить по проекту, как нарисовано. Установлены какие то хитрые ЗСУ с фотодатчиком основной горелки в составе.
Имеет ли смысл на фукционалке показывать отдельно ЛУЧ, ИВН и маркировать отдельно - они же по сути как раз все в составе ЗСУ. Дать одну маркировку и все. А на схеме подключения изобразить какой кабель/жилы идут на ИВН, какие на Луч, а какие на ФДСА, если он также в составе ЗСУ
Обратите внимание на шифр X - не знаем как назвать, называем X. Особенно, когда устройство комплексное
А где контроль загазованности? В исходном не было? Нужно добавить, иначе нам ЭПБ не подпишут
Зачем то стоблец Ед.Изм.не по назначению использовали
Это заготовка для таблицы базы данных в будущем, поэтому надо 1 позиция - 1 строка, а не много позиций в 1 строке
Сделайте копию этого листа в начало документа. Поправьте функционалку, уберите все цветное и назовите исправленный лист в формате YYMMDDлуз
Также сделайте файл model371.dwg для Рафиса, когда все решения устаканятся. Чтобы он добавил в функционалку арматуру с ручным приводом и показал у себя в разделе

Sheet: 240423луз
шифр | назначение | наименование | производитель | предел от | предел до | ед.изм | Ду | эн.потр | масса | цена без НДС | дата цены | схема эл. | схема монт. | параметры схем
g8V001 | Клапан НЗ продувки между задвижками | КМГ-50Ф-100 | Теплотехника, Переяславль-Залесский |  | 100 |  | 50 |  | 5.4 | 20590 | 2024-04-22
g8M002 | Задвижка общекотловая | 30с 941нж с электроприводом ГЗ-Б.300/24, 380В | Южноураларматура, Миасс |  | 1600 |  | 200 |  | 127 | 234720 | 2024-04-22
g8V001 | Клапан НЗ продувки газопровода перед ГОК | КМГ-50Ф-100 | Теплотехника, Переяславль-Залесский |  | 100 |  | 50 |  | 5.4 | 20590 | 2024-04-22
g8V003 | Главный ПЗК НЗ котла | КМГ-200Ф-100 | Теплотехника, Переяславль-Залесский |  | 100 |  | 200 |  | 79.0 | 191490 | 2024-04-22
g8sM004 | Заслонка общекотловая | ЗГД-150ФМ3-600, привод МЭОФ | Теплотехника, Переяславль-Залесский |  | 600 |  | 150 |  | 15.0 | 30910 | 2024-04-22
g8V005 | Клапан НЗ продувки газопровода из тупика | КМГ-50Ф-100 | Теплотехника, Переяславль-Залесский |  | 100 |  | 50 |  | 5.4 | 20590 | 2024-04-22
g8V101 | ПЗК1 НЗ группы горелок 1 | КМГ-150Ф-100 | Теплотехника, Переяславль-Залесский |  | 100 |  | 150 |  | 64.0 | 120720 | 2024-04-22
g8V201 | ПЗК1 НЗ группы горелок 2 | КМГ-150Ф-100 | Теплотехника, Переяславль-Залесский |  | 100 |  | 150 |  | 64.0 | 120720 | 2024-04-22
g8V111 | ПЗК2 НЗ горелки 1 | КМГ-100ФР-100 | Теплотехника, Переяславль-Залесский |  | 100 |  | 100 |  | 17.6 | 51300 | 2024-04-22
g8V121 | ПЗК2 НЗ горелки 2 | КМГ-100ФР-100 | Теплотехника, Переяславль-Залесский |  | 100 |  | 100 |  | 17.6 | 51300 | 2024-04-22
g8V131 | ПЗК2 НЗ горелки 3 | КМГ-100ФР-100 | Теплотехника, Переяславль-Залесский |  | 100 |  | 100 |  | 17.6 | 51300 | 2024-04-22
g8V241 | ПЗК2 НЗ горелки 4 | КМГ-100ФР-100 | Теплотехника, Переяславль-Залесский |  | 100 |  | 100 |  | 17.6 | 51300 | 2024-04-22
g8V251 | ПЗК2 НЗ горелки 5 | КМГ-100ФР-100 | Теплотехника, Переяславль-Залесский |  | 100 |  | 100 |  | 17.6 | 51300 | 2024-04-22
g8V251 | ПЗК2 НЗ горелки 6 | КМГ-100ФР-100 | Теплотехника, Переяславль-Залесский |  | 100 |  | 100 |  | 17.6 | 51300 | 2024-04-22
g8V102 | Клапан НЗ опрессовки группы горелок 1 | КМГ-20-100 | Теплотехника, Переяславль-Залесский |  | 100 |  | 20 |  | 2.8 | 11540 | 2024-04-22
g8V202 | Клапан НЗ опрессовки группы горелок 2 | КМГ-20-100 | Теплотехника, Переяславль-Залесский |  | 100 |  | 20 |  | 2.8 | 11540 | 2024-04-22
g8V103 | Клапан НО безопасности группы горелок 1 | КМГ-20НО-100 | Теплотехника, Переяславль-Залесский |  | 100 |  | 20 |  | 2.6 | 14210 | 2024-04-22
g8V203 | Клапан НО безопасности группы горелок 2 | КМГ-20НО-100 | Теплотехника, Переяславль-Залесский |  | 100 |  | 20 |  | 2.6 | 14210 | 2024-04-22
g8V113 | Клапан НЗ запальника горелки 1 | КМГ-20-100 | Теплотехника, Переяславль-Залесский |  | 100 |  | 20 |  | 2.8 | 11540 | 2024-04-22
g8V123 | Клапан НЗ запальника горелки 2 | КМГ-20-100 | Теплотехника, Переяславль-Залесский |  | 100 |  | 20 |  | 2.8 | 11540 | 2024-04-22
g8V133 | Клапан НЗ запальника горелки 3 | КМГ-20-100 | Теплотехника, Переяславль-Залесский |  | 100 |  | 20 |  | 2.8 | 11540 | 2024-04-22
g8V243 | ПЗККлапан | КМГ-20-100 | Теплотехника, Переяславль-Залесский |  | 100 |  | 20 |  | 2.8 | 11540 | 2024-04-22
g8V253 | Клапан НЗ запальника горелки 5 | КМГ-20-100 | Теплотехника, Переяславль-Залесский |  | 100 |  | 20 |  | 2.8 | 11540 | 2024-04-22
g8V263 | Клапан НЗ запальника горелки 6 | КМГ-20-100 | Теплотехника, Переяславль-Залесский |  | 100 |  | 20 |  | 2.8 | 11540 | 2024-04-22
g8sM112 | Заслонка горелки 1 | ЗГД-100ФМ3-600, привод МЭОФ | Теплотехника, Переяславль-Залесский |  | 600 |  | 100 |  | 6.7 | 25200 | 2024-04-22
g8sM122 | Заслонка горелки 2 | ЗГД-100ФМ3-600, привод МЭОФ | Теплотехника, Переяславль-Залесский |  | 600 |  | 100 |  | 6.7 | 25200 | 2024-04-22
g8sM132 | Заслонка горелки 3 | ЗГД-100ФМ3-600, привод МЭОФ | Теплотехника, Переяславль-Залесский |  | 600 |  | 100 |  | 6.7 | 25200 | 2024-04-22
g8sM242 | Заслонка горелки 4 | ЗГД-100ФМ3-600, привод МЭОФ | Теплотехника, Переяславль-Залесский |  | 600 |  | 100 |  | 6.7 | 25200 | 2024-04-22
g8sM252 | Заслонка горелки 5 | ЗГД-100ФМ3-600, привод МЭОФ | Теплотехника, Переяславль-Залесский |  | 600 |  | 100 |  | 6.7 | 25200 | 2024-04-22
g8sM262 | Заслонка горелки 6 | ЗГД-100ФМ3-600, привод МЭОФ | Теплотехника, Переяславль-Залесский |  | 600 |  | 100 |  | 6.7 | 25200 | 2024-04-22
g8Pt101 | Давление между клапанов группы горелок 1 | Преобразователь давления измерительный АИР-10/-/SH/ДИ/1130/-/-/0...60кПа/C05/АГ-15И/М20/11N/t4070/42/IP65/PGM/-/-/-/-/-/-/KKS/-/-/-/ГП/ТУ | Элемер, Зеленоград МО | 0 | 60 | кПа |  |  | 2 | 43680 | 2024-04-22
g8Pt201 | Давление между клапанов группы горелок 2 | Преобразователь давления измерительный АИР-10/-/SH/ДИ/1130/-/-/0...60кПа/C05/АГ-15И/М20/11N/t4070/42/IP65/PGM/-/-/-/-/-/-/KKS/-/-/-/ГП/ТУ | Элемер, Зеленоград МО | 0 | 60 | кПа |  |  | 2 | 43680 | 2024-04-22
g8Pt001 | Давление газа перед общекотловой заслонкой | Преобразователь давления измерительный АИР-20/М2/-/Н//ДИ/130/-/М20/11N/А3И1/t4070/А00/0...60кПа/42/ШР-14/К1+/IP65/КР2/Т7ФУ/-/KKS/ГП/ТУ | Элемер, Зеленоград МО | 0 | 60 | кПа |  |  | 2 | 76895 | 2024-04-22
g8Pt002 | Давление газа перед общекотловой заслонкой | Преобразователь давления измерительный АИР-20/М2/-/Н//ДИ/120/-/М20/11N/А3И1/t4070/A01/0...40кПа/42/ШР-14/К1+/IP65/КР2/Т7ФУ/-/KKS/ГП/ТУ | Элемер, Зеленоград МО | 0 | 40 | кПа |  |  | 2 | 76245 | 2024-04-22
g8dPt003 | Перепад давление газа на диафрагме (расход) клапанным блоком | Преобразователь давления измерительный АИР-20/М2/-/Н//ДД/410/-/-/11V/А3И1/t4070/A01/0...6,3кПа/10МПа/42/ШР-14/К1+/IP65/КР3/-/Y(С30)/KKS/ГП/ТУ, Блок клапанный ЭЛЕМЕР-БК/С/3/0/-/02/03/Р5/t4070 У3/ДР/М20УМ/- | Элемер, Зеленоград МО | 0 | 6.3 | кПа |  |  | 6 | 132470 | 2024-04-22
g8Te001 | Температура газа перед котлом | Термопреобразователь сопротивления ТС-1088/-/1/-/50М/-50…+200°С/160/10/В/АГ-10/С/Сх.№2/ГП/ЭП | Элемер, Зеленоград МО | -50 | 200 | град.С |  |  | 0.8 | 4705 | 2024-04-22
a8Pt001 | Давление воздуха в общем коробе | Преобразователь давления измерительный АИР-20/М2/-/Н//ДИ/114/-/-/11V/А3И1/t4070/A01/0...2,5кПа/42/ШР-14/К1+/IP65/КР3/С5ФФ/-/KKS/ГП/ТУ | Элемер, Зеленоград МО | 0 | 2.5 | кПа |  |  | 2 | 115505 | 2024-04-22
a8Te001 | Температура воздуха в общем коробе | Термопреобразователь сопротивления ТС-1088/-/1/-/50М/-50…+200°С/400/10/В/АГ-10/С/Сх.№2/ГП/ЭП | Элемер, Зеленоград МО | -50 | 200 | град.С |  |  |  | 5060 | 2024-04-22
f8Pt001 | Разрежение в топке котла | Преобразователь давления измерительный АИР-20/М2/-/Н//ДИВ/304/-/-/11V/А3И1/t4070/B02/-0,2...2,0кПа/42/ШР-14/К1+/IP65/КР3/С5ФФ/-/KKS/ГП/ТУ | Элемер, Зеленоград МО | -0.2 | 0.2 | кПа |  |  | 5 | 118885 | 2024-04-22
f8Te001 | Температура дымовых газов за котлом | Термопреобразователь сопротивления ТС-1088/-/1/-/100П/–100…+450С/500/10/А/АГ-10/С/Сх.№2/ГП/ЭП | Элемер, Зеленоград МО | -100 | 450 | град.С |  |  | 0.8 | 5905 | 2024-04-22
w8Te001 | Температура теплоносителя до котла | Термопреобразователь сопротивления ТС-1088/-/1/-/50М/-50…+200°С/250/10/С/АГ-10/С/Сх.№2/ГП/ЭП | Элемер, Зеленоград МО | -50 | 200 | град.С |  |  | 0.8 | 4840 | 2024-04-22
w8TE002 | Температура теплоносителя до котла | Термопреобразователь сопротивления ТС-1088/-/1/-/50М/-50…+200°С/250/10/С/АГ-10/С/Сх.№2/ГП/ЭП | Элемер, Зеленоград МО | -50 | 200 | град.С |  |  | 0.8 | 4840 | 2024-04-22
w8TE003 | Температура теплоносителя до котла (дубль) | Термопреобразователь сопротивления ТС-1088/-/1/-/50М/-50…+200°С/250/10/С/АГ-10/С/Сх.№2/ГП/ЭП | Элемер, Зеленоград МО | -50 | 200 | град.С |  |  | 0.8 | 4840 | 2024-04-22
w8Pt001 | Давление теплоносителя до котла | Преобразователь давления измерительный АИР-20/М2/-/Н//ДИ/160/-/М20/11N/А3И1/t4070/А00/0...1,6МПа/42/ШР-14/К1+/IP65/КР2/Т7ФУ/-/KKS/ГП/ТУ | Элемер, Зеленоград МО | 0 | 1.6 | Мпа |  |  | 2 | 76895 | 2024-04-22
w8Pt002 | Давление теплоносителя после котла | Преобразователь давления измерительный АИР-20/М2/-/Н//ДИ/160/-/М20/11N/А3И1/t4070/А00/0...1,6МПа/42/ШР-14/К1+/IP65/КР2/Т7ФУ/-/KKS/ГП/ТУ | Элемер, Зеленоград МО | 0 | 1.6 | Мпа |  |  | 2 | 76895 | 2024-04-22
w8dPt001 | Перепад Давление теплоносителя на диафрагме | Преобразователь давления измерительный АИР-20/М2/-/Н//ДД/440/-/-/11V/А3И1/t4070/А00/0...63кПа/10МПа/42/ШР-14/К1+/IP65/КР3/-/Y(С30)/KKS/ГП/ТУ; Блок клапанный ЭЛЕМЕР-БК/С/3/0/-/02/03/Р5/t4070 У3/ДР/М20УМ/- | Элемер, Зеленоград МО | 0 | 63 | кПа |  |  | 6 | 132470 | 2024-04-22
w8Psg001 | ЭКМ на трубопроводе воды за котлом | Электроконтактный манометр ЭКМ 2005/-/ДИ/ИМ1,6М/1,6/МПа/D/V/А16И1/t0550/24/-/GSP/М20/11N/-/ГП/ЭП | Элемер, Зеленоград МО | 0 | 1.6 | МПа |  |  |  | 55450 | 2024-04-22
g8Pg001 | Давление газа между задвижками | Манометр показывающий МП4-У У2; 0-60 кПа кл.1,0 160мм | Манотомь, Томск | 0 | 60 | кПа
g8Pg002 | Давление газа перед главным отсекающим клапаном | Манометр показывающий МП4-У У2; 0-60 кПа кл.1,0 160мм | Манотомь, Томск | 0 | 60 | кПа
g8Pg003 | Давление газа до общей заслонки газа | Манометр показывающий МП4-У У2; 0-60 кПа кл.1,0 160мм | Манотомь, Томск | 0 | 60 | кПа
g8Pg004 | Давление газа после общей заслонки газа | Манометр показывающий МП4-У У2; 0-60 кПа кл.1,0 160мм | Манотомь, Томск | 0 | 60 | кПа
g8Pg101 | Давление газа перед группой горелок 1 | Напоромер мембранный НМП-100- М1Р-40кПа. ТУ-25-7305.016-90 | Саранский приборострительный завод | 0 | 40 | кПа
g8Pg201 | Давление газа перед группой горелок 2 | Напоромер мембранный НМП-100- М1Р-40кПа. ТУ-25-7305.016-90 | Саранский приборострительный завод | 0 | 40 | кПа
g8Pt111 | Давление газа перед горелкой 1 | Напоромер мембранный НМП-52-М2- 40кПа-1,5- У3 | Саранский приборострительный завод | 0 | 40 | кПа
g8Pt121 | Давление газа перед горелкой 2 | Напоромер мембранный НМП-52-М2- 40кПа-1,5- У3 | Саранский приборострительный завод | 0 | 40 | кПа
g8Pt131 | Давление газа перед горелкой 3 | Напоромер мембранный НМП-52-М2- 40кПа-1,5- У3 | Саранский приборострительный завод | 0 | 40 | кПа
g8Pt241 | Давление газа перед горелкой 4 | Напоромер мембранный НМП-52-М2- 40кПа-1,5- У3 | Саранский приборострительный завод | 0 | 40 | кПа
g8Pt251 | Давление газа перед горелкой 5 | Напоромер мембранный НМП-52-М2- 40кПа-1,5- У3 | Саранский приборострительный завод | 0 | 40 | кПа
g8Pt261 | Давление газа перед горелкой 6 | Напоромер мембранный НМП-52-М2- 40кПа-1,5- У3 | Саранский приборострительный завод | 0 | 40 | кПа
g8Ps001 | Давление газа после заслонки котла (Рмин) | Датчик-реле DG30В-3 0,25…3 кПа G.Kromschroeder. | Волгатерм, Нижний Новгород | 0.25 | 3 | кПа |  |  | 0.3 | 25961 | сайт
g8Ps002 | Давление газа после заслонки котла (Рмакс) | Датчик-реле DG500В-3 10…50 кПа G.Kromschroeder. | Волгатерм, Нижний Новгород | 10 | 50 | кПа |  |  | 0.3 | 27938 | сайт
a8Pg111 | Давление воздуха перед горелкой 1 | Напоромер мембранный НМП-52-М2- 2,5кПа-1,5- У3 | Саранский приборострительный завод | 0 | 2.5 | кПа
a8Pg121 | Давление воздуха перед горелкой 2 | Напоромер мембранный НМП-52-М2- 2,5кПа-1,5- У3 | Саранский приборострительный завод | 0 | 2.5 | кПа
a8Pg131 | Давление воздуха перед горелкой 3 | Напоромер мембранный НМП-52-М2- 2,5кПа-1,5- У3 | Саранский приборострительный завод | 0 | 2.5 | кПа
a8Pg241 | Давление воздуха перед горелкой 4 | Напоромер мембранный НМП-52-М2- 2,5кПа-1,5- У3 | Саранский приборострительный завод | 0 | 2.5 | кПа
a8Pg251 | Давление воздуха перед горелкой 5 | Напоромер мембранный НМП-52-М2- 2,5кПа-1,5- У3 | Саранский приборострительный завод | 0 | 2.5 | кПа
a8Pg261 | Давление воздуха перед горелкой 6 | Напоромер мембранный НМП-52-М2- 2,5кПа-1,5- У3 | Саранский приборострительный завод | 0 | 2.5 | кПа
a8Ps111 | Давление воздуха перед горелкой 1 (Рмин) | Датчик-реле DG10А-31 0,1…1 кПа G.Kromschroeder. | Волгатерм, Нижний Новгород | 0.1 | 1 | кПа |  |  | 0.3 | 25059 | сайт
a8Ps121 | Давление воздуха перед горелкой 2 (Рмин) | Датчик-реле DG10А-31 0,1…1 кПа G.Kromschroeder. | Волгатерм, Нижний Новгород | 0.1 | 1 | кПа |  |  | 0.3 | 25059 | сайт
a8Ps131 | Давление воздуха перед горелкой 3 (Рмин) | Датчик-реле DG10А-31 0,1…1 кПа G.Kromschroeder. | Волгатерм, Нижний Новгород | 0.1 | 1 | кПа |  |  | 0.3 | 25059 | сайт
a8Ps241 | Давление воздуха перед горелкой 4 (Рмин) | Датчик-реле DG10А-31 0,1…1 кПа G.Kromschroeder. | Волгатерм, Нижний Новгород | 0.1 | 1 | кПа |  |  | 0.3 | 25059 | сайт
a8Ps251 | Давление воздуха перед горелкой 5 (Рмин) | Датчик-реле DG10А-31 0,1…1 кПа G.Kromschroeder. | Волгатерм, Нижний Новгород | 0.1 | 1 | кПа |  |  | 0.3 | 25059 | сайт
a8Ps261 | Давление воздуха перед горелкой 6 (Рмин) | Датчик-реле DG10А-31 0,1…1 кПа G.Kromschroeder. | Волгатерм, Нижний Новгород | 0.1 | 1 | кПа |  |  | 0.3 | 25059 | сайт
a8Pg101 | Давления воздуха после вентилятора группы горелок 1 | Напоромер мембранный НМП-52-М2- 2,5кПа-1,5- У3 | Саранский приборострительный завод | 0 | 2.5 | кПа
a8Pg201 | Давления воздуха после вентилятора группы горелок 2 | Напоромер мембранный НМП-52-М2- 2,5кПа-1,5- У3 | Саранский приборострительный завод | 0 | 2.5 | кПа
a8Pg001 | Давления воздуха в общем коллекторе | Напоромер мембранный НМП-52-М2- 2,5кПа-1,5- У3 | Саранский приборострительный завод | 0 | 2.5 | кПа
f8Pg001 | Разрежение в топке котла | Тягонапоромер мембранный ТНМП-100-М1- ±0,125кПа-1,5- У3 | Саранский приборострительный завод | -0.125 | 0.125 | кПа
f8Ps001 | Разрежение в топке котла (мин разреж) | Датчик-реле DL1,5A-3Z -50…150 Па G.Kromschroeder. | Волгатерм, Нижний Новгород | -50 | 150 | Па |  |  | 0.3 | 27400 | сайт
f8Pg002 | Разрежение перед дымососом | Тягонапоромер мембранный ТмМП-52-М2- 0,6кПа..0-1,5- У3 | Саранский приборострительный завод | -0.6 | 0 | кПа
w8Tg001 | Температура теплоносителя до котла | Термометр биметаллический ТБ-2Р(0…200)-1,5-250-10-М20 ТУ 311-00225621.160-96 | Теплоконтроль, Казань | 0 | 200 | град.С
w8Tg002 | Температура теплоносителя после котла | Термометр биметаллический ТБ-2Р(0…200)-1,5-250-10-М20 ТУ 311-00225621.160-96 | Теплоконтроль, Казань | 0 | 200 | град.С
w8Pg001 | Давление теплоносителя до котла | Манометр показывающий МП4-У У2; 0-1,6 МПа кл.1,0 160мм | Манотомь, Томск | 0 | 1.6 | МПа
w8Pg002 | Давление теплоносителя после котла | Манометр показывающий МП4-У У2; 0-1,6 МПа кл.1,0 160мм | Манотомь, Томск | 0 | 1.6 | МПа
a8sM111 | Шибер воздуха горелки 1 | МЭО-100/25-0,25У-08 | СКБ СПА, Чебоксары
a8sM121 | Шибер воздуха горелки 2 | МЭО-100/25-0,25У-08 | СКБ СПА, Чебоксары
a8sM131 | Шибер воздуха горелки 3 | МЭО-100/25-0,25У-08 | СКБ СПА, Чебоксары
a8sM241 | Шибер воздуха горелки 4 | МЭО-100/25-0,25У-08 | СКБ СПА, Чебоксары
a8sM251 | Шибер воздуха горелки 5 | МЭО-100/25-0,25У-08 | СКБ СПА, Чебоксары
a8sM261 | Шибер воздуха горелки 6 | МЭО-100/25-0,25У-08 | СКБ СПА, Чебоксары
a8sM101 | Шибер воздуха вентилятора группы горелок 1 | МЭО-250/63-0,25У-08К | СКБ СПА, Чебоксары
a8sM201 | Шибер воздуха вентилятора группы горелок 2 | МЭО-250/63-0,25У-08К | СКБ СПА, Чебоксары
f8sM001 | Шибер дымососа | МЭО-630/63-0,25У-08К | СКБ СПА, Чебоксары
b8X111 | Защитно сигнализир. Устройство горелки 1 | ЗСУ-ПИ-60-700-05 в комплекте | НПП ПромАВ, Казань
 | Датчик пламени запальника горелки 1 | ЛУЧ-КЭ-Щ | НПП ПромАВ, Казань |  |  |  |  |  |  | 10020 | 2023-10-01
 | Источник высокого напряжения | ИВН-ТРМ | НПП ПромАв, Казань |  |  |  |  |  |  | 4596 | 2023-10-01
b8X101 | Датчик пламени растопочной горелки 1 | ФДСА-03М-01, узел монтажный и фланец к нему | НПП ПромАв, Казань |  |  |  |  |  |  | 42192 | 2023-10-01
b8X121 | Защитно сигнализир. Устройство горелки 2 | ЗСУ-ПИ-60-700-01 в комплекте | НПП ПромАВ, Казань
 | Датчик пламени запальника горелки 2 | ЛУЧ-КЭ-Щ | НПП ПромАВ, Казань |  |  |  |  |  |  | 10020 | 2023-10-01
 | Источник высокого напряжения | ИВН-ТРМ | НПП ПромАв, Казань |  |  |  |  |  |  | 4596 | 2023-10-01
b8X121 | Защитно сигнализир. Устройство горелки 3 | ЗСУ-ПИ-60-700-01 в комплекте | НПП ПромАВ, Казань
 | Датчик пламени запальника горелки 3 | ЛУЧ-КЭ-Щ | НПП ПромАВ, Казань |  |  |  |  |  |  | 10020 | 2023-10-01
 | Источник высокого напряжения | ИВН-ТРМ | НПП ПромАв, Казань |  |  |  |  |  |  | 4596 | 2023-10-01
b8X231 | Защитно сигнализир. Устройство горелки 4 | ЗСУ-ПИ-60-700-01 в комплекте | НПП ПромАВ, Казань
 | Датчик пламени запальника горелки 4 | ЛУЧ-КЭ-Щ | НПП ПромАВ, Казань |  |  |  |  |  |  | 10020 | 2023-10-01
 | Источник высокого напряжения | ИВН-ТРМ | НПП ПромАв, Казань |  |  |  |  |  |  | 4596 | 2023-10-01
b8X221 | Защитно сигнализир. Устройство горелки 5 | ЗСУ-ПИ-60-700-01 в комплекте | НПП ПромАВ, Казань
 | Датчик пламени запальника горелки 5 | ЛУЧ-КЭ-Щ | НПП ПромАВ, Казань |  |  |  |  |  |  | 10020 | 2023-10-01
 | Источник высокого напряжения | ИВН-ТРМ | НПП ПромАв, Казань |  |  |  |  |  |  | 4596 | 2023-10-01
b8X211 | Защитно сигнализир. Устройство горелки 6 | ЗСУ-ПИ-60-700-05 в комплекте | НПП ПромАВ, Казань
 | Датчик пламени запальника горелки 6 | ЛУЧ-КЭ-Щ | НПП ПромАВ, Казань |  |  |  |  |  |  | 10020 | 2023-10-01
 | Источник высокого напряжения | ИВН-ТРМ | НПП ПромАв, Казань |  |  |  |  |  |  | 4596 | 2023-10-01
b8X201 | Датчик пламени растопочной горелки 6 | ФДСА-03М-01, узел монтажный и фланец к нему | НПП ПромАв, Казань |  |  |  |  |  |  | 42192 | 2023-10-01

Sheet: 240415кор
шифр | назначение | наименование | производитель | предел от | предел до | ед.изм | Ду | эн.потр | масса | цена без НДС | дата цены | схема эл. | схема монт. | параметры схем
