nppesnteam/371-24_EKB_academ_PTVM30_-8/(list of files, cad)

Other CAD files:
Структурная схема автоматизации.dwg
