nppesnteam/371-24_EKB_academ_PTVM30_-8/model371.pdf

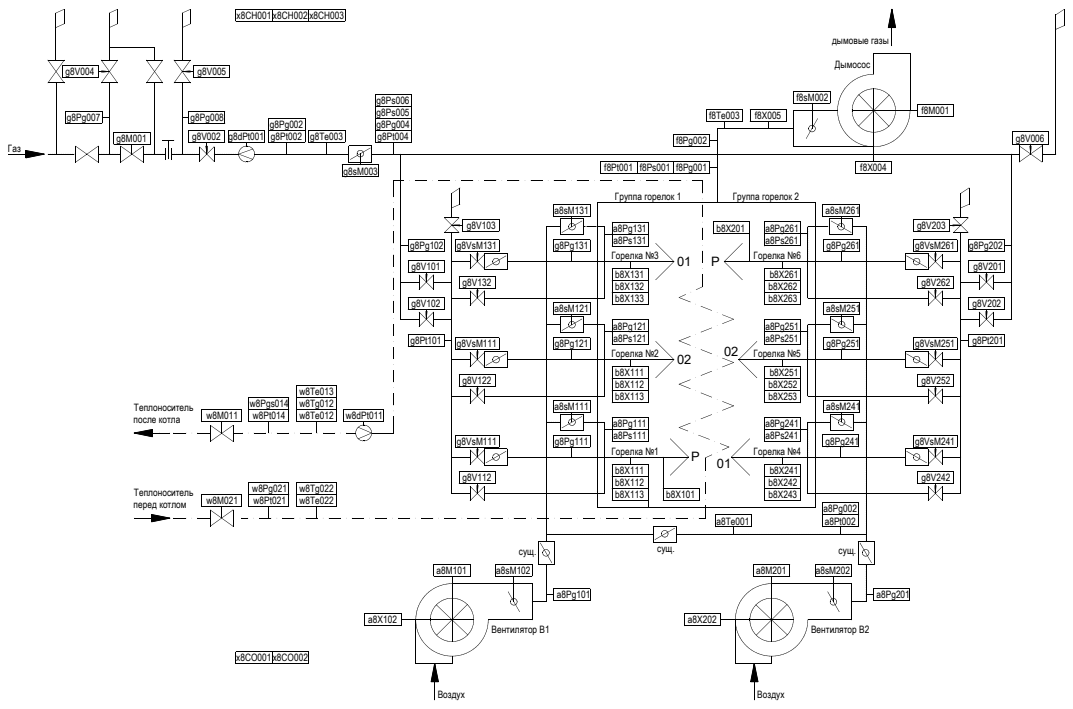
[picture p12: page 1]
Вентилятор В1; Воздух; Дымосос; сущ.; сущ. сущ.; Горелка №1; Группа горелок 1; Группа горелок 2; Газ; Теплоноситель после котла; g8dPt001; g8VsM111; дымовые газы; Теплоноситель перед котлом; Вентилятор В2; Горелка №2; Горелка №3; Горелка №4; Горелка №5; Горелка №6; w8dPt011; w8Pgs014 w8Pt014; g8VsM131; g8VsM241; g8VsM251; g8VsM261
