nppesnteam/371-24_EKB_academ_PTVM30_-8/Функционалка.pdf

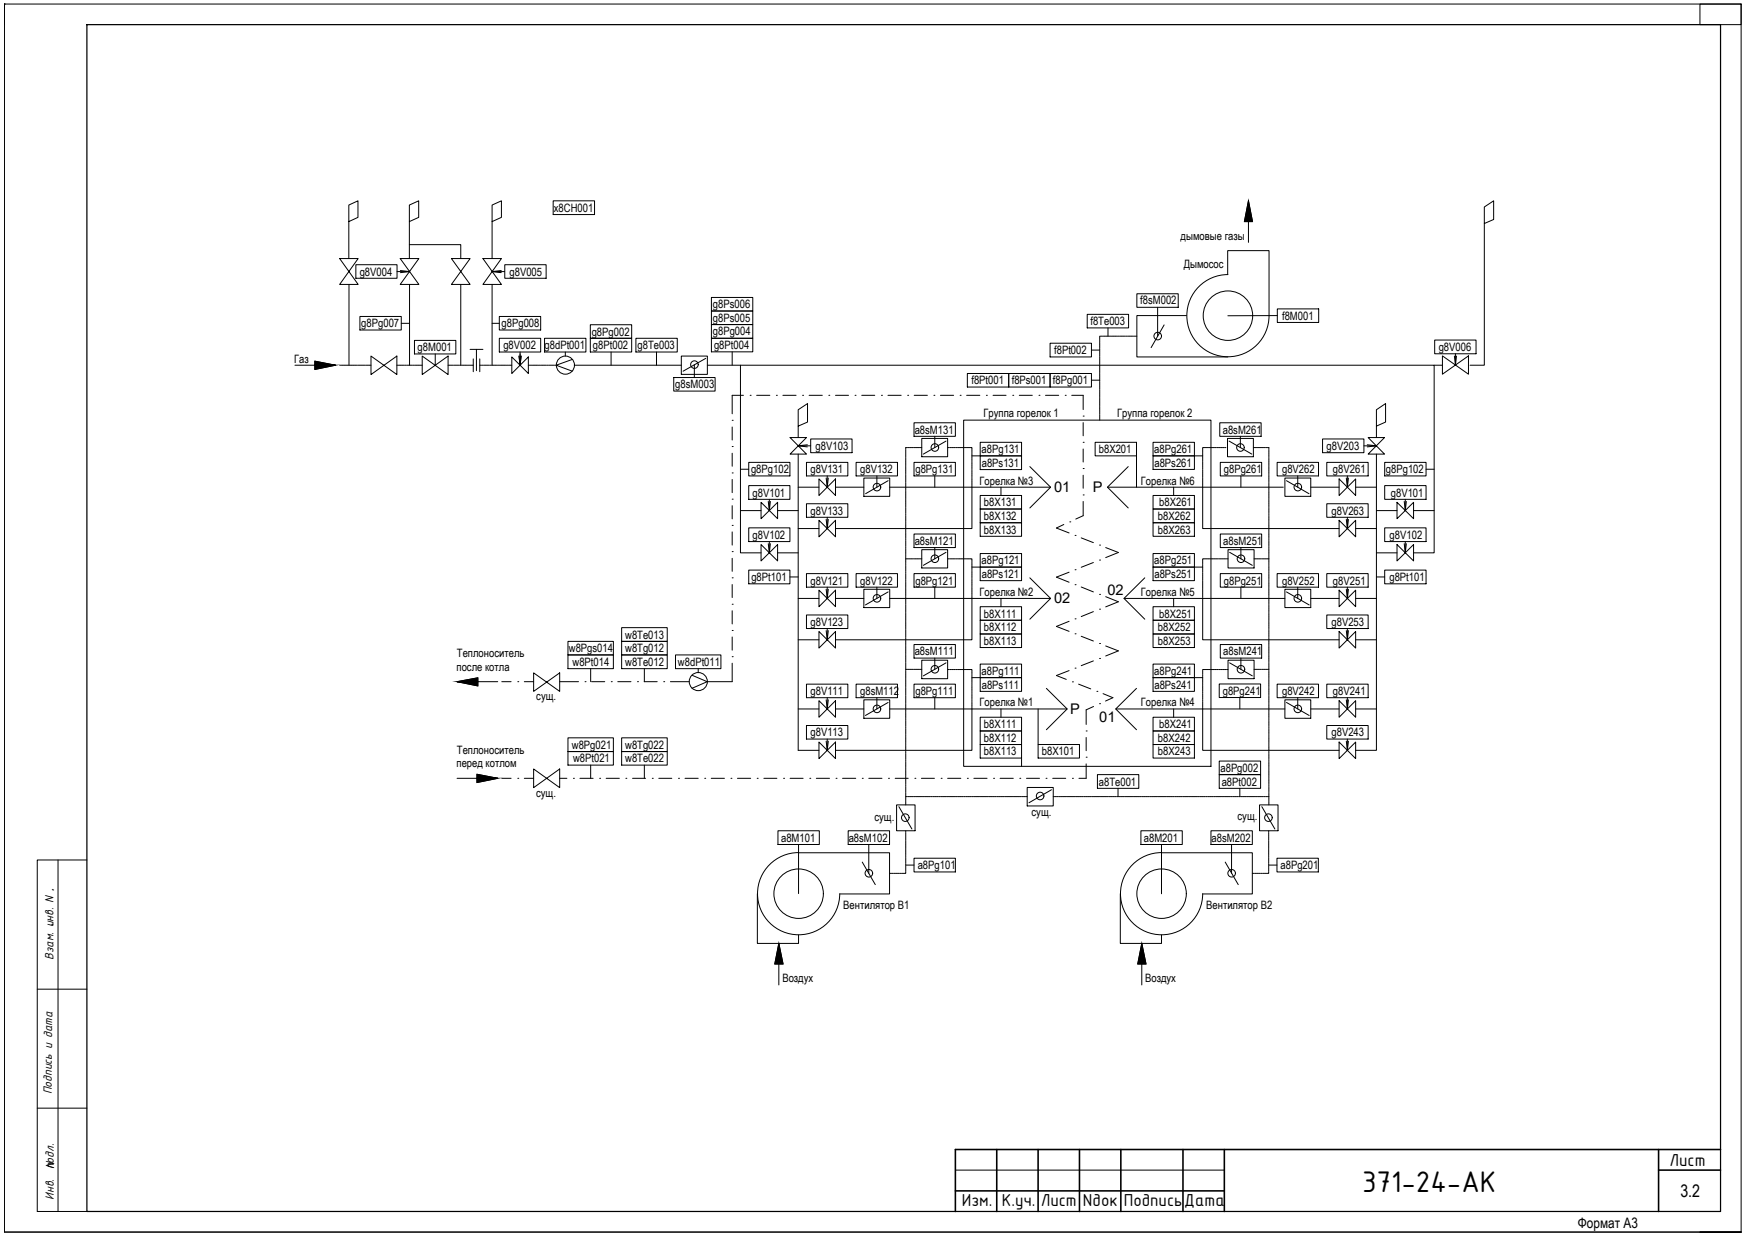
[picture p13: page 1]
Формат А3; Лист; Изм.; Nдок; ПодписьДата; Вентилятор В1; Воздух; Дымосос; сущ.; сущ. сущ.; Горелка №1; Группа горелок 1; Группа горелок 2; Газ; g8dPt001; дымовые газы; Теплоноситель перед котлом; Вентилятор В2; Горелка №2; Горелка №3; Горелка №4; Горелка №5; Горелка №6; w8dPt011; w8Pgs014 w8Pt014

Теплоноситель после котла

Подпись и дата Инв. подл. N Взам. инв. N .
